gitDiceman/dspic33chSchematic/README.md

# dspic33chSchematic
hfc3100D dspic33ch128mp506 schematic
