gitDiceman/dspic33chSchematic/NEW_33CH128_SCHEMATIC/HFC3100D_Main Control_220928_Rev2_1_BOM_220928(수정221014).xlsx

자 재 명 세 서
품 명 : 축전지용 충전기 |  |  |  |  |  |  |  |  | 10/14수정
MODEL : HFC3100D |  |  |  |  | PART : Main Control B/D
NO : 22-04-25 Rev 2.0 -> Rev 2.1 |  |  |  |  |  |  |  |  | 2022.10.14
NO | 품명 | 심볼 | TYPE | 규격 | 단위 | 수량 | 단가 | 금액 | 비고
1 | CAP. | C21,C25,C26,C27,C28, C29,C30,C31,C34,C37, C40,C41,C42,C43,C44, C45,C46,C47,C48,C51, C52,C53,C54,C55,C62, C71,C72,C73,C74,C75, C76,C77,C78,C79,C80, C83,C84,C24 | SMD (2012) | C104/2012 | EA | 38 | 60 | 2280
2 |  | C61_X,C64_X,C69_X |  | C105/2012 | EA | 0
3 |  | BT1 |  | S-CAP-1F/5.5V/20pi/5pitch | EA | 0 |  |  | 미삽
4 |  | C1 | EL | 100uF/250V | EA | 1 | 60 | 60
5 |  | C2,C3 | MY | M104/2E | EA | 2 | 60 | 120
6 |  | C4 | CC | C331/1KV | EA | 1 | 60 | 60
7 |  | C5,C7,C8 | EL | 1000uF/25V | EA | 3 | 60 | 180
8 |  | C6 | EL | 47uF/25V | EA | 1 | 60 | 60
9 |  | C9,C14 | CC | C104 | EA | 2 | 60 | 120
10 |  | C10 | CC | 471C | EA | 1 | 60 | 60
11 |  | C11,C12,C16,C19 | EL | 220uF/50V | EA | 4 | 60 | 240
12 |  | C22,C32,C35,C49 | SMD(2012) | C222/50V(2012) | EA | 5 | 60 | 300
13 |  | C15 | EL | 100uF/50V | EA | 1 | 60 | 60
14 |  | C17,C20 | EL | 47uF/50V | EA | 2 | 60 | 120
15 |  | C18,C13 | MY | M222/2A | EA | 2 | 60 | 120
16 |  | C23,C33 | MY | M473/250V(630V) | EA | 2 | 60 | 120
17 |  | C36 | EL | 470u/25V | EA | 1 | 60 | 60
18 |  | C38,C39 | SMD(2012) | 30P/2012 | EA | 2 | 60 | 120
19 |  | C50 | MY | M474/16V | EA | 1 | 60 | 60
20 |  | C56_X,C57_X,C58_X |  | 47uF | EA | 0 |  |  | 미삽
21 |  | C60_X,C63_X,C68_X |  | 22uF | EA | 0 |  |  | 미삽
22 |  | C70 |  | 10uF/50V | EA | 0 | 60 | 0 | 미삽
23 |  | C81,C82 |  | 220uF/25V/8pi | EA | 2 | 60 | 120
24 | DIODE | D1,D3,D8,D11,D13,D14,D15,D23 |  | UF4007 | EA | 8 | 60 | 480
25 |  | D2,D4 |  | 1N5404 | EA | 2 | 60 | 120
26 |  | D5,D7,D12 |  | UF5401 | EA | 3 | 60 | 180
27 |  | D6 |  | 1N5406 | EA | 1 | 60 | 60
28 |  | D9 |  | 1N4747 | EA | 1 | 60 | 60
29 |  | D10 |  | 1N4749 | EA | 1 | 60 | 60
30 |  | D16,D17,D18,D19,D20,D21,D24,D25 | SMD | 1N4148/SOD80 | EA | 8 | 60 | 480
31 |  | D22 |  | 1N4733 | EA | 1 | 60 | 60
32 |  | D26_X,D27_X,D28_X,D29_X,D30_X, D31_X |  | 1N4007 | EA | 0 |  |  | 미삽
33 |  | D33,D34 |  | SMBJ13CA | EA | 2 | 60 | 120
34 | CONN. | J2 |  | 53258-8P | EA | 1 | 60 | 60
35 |  | J3 |  | 53258(2P) | EA | 0 | 60 | 0 | 미삽
36 |  | J1 |  | PCN10-64ACP-2.54DS | EA | 1 | 60 | 60
37 |  | J4 |  | HIF3BA-20PA-2.54DSA | EA | 0 | 60 | 0 | 미삽
38 |  | J5 |  | 5269-5P | EA | 1 | 60 | 60
39 |  | J6 |  | 5267-5P | EA | 1 | 60 | 60
40 | FET | Q1 |  | IRF830 | EA | 1 | 60 | 60
41 | TR | Q2 |  | 2N2222/SOT23 | EA | 0 | 60 | 0 | 미삽
42 | NTC | RT1,RT2 |  | 20D15 | EA | 2 | 60 | 120
43 | RES. | R18,R30,R43 | SMD (3216) | 3K/3216 | EA | 3 | 60 | 180
44 |  | R19,R22,R39,R42 |  | 100K/3216 | EA | 4 | 60 | 240 | R84_X,R89_X, R96_X-미삽
45 |  | R20,R40,R45,R64 |  | 270R/3216 | EA | 4 | 60 | 240
46 |  | R21,R41,R63 |  | 100R/3216 | EA | 3 | 60 | 180
47 |  | R23,R24,R25,R26,R27,R28,R29,R46, R47,R48,R49,R50,R51,R52,R74, |  | 10K/3216 | EA | 15 | 60 | 900 | R85_X,R90_X, R97_X-미삽
48 |  | R31,R32,R33,R34,R36,R37,R38,R55, R56,R57,R58,R59,R60,R61 |  | 1R/3216 | EA | 14 | 60 | 840
49 |  | R44 |  | 4K/3216 | EA | 1 | 60 | 60
50 |  | R53 |  | 3.8k/3216 | EA | 1 | 60 | 60
51 |  | R54 |  | 33k/3216 | EA | 1 | 60 | 60
52 |  | R62,R65,R66,R70,R71,R107,R108, R109,R110, R111,R112,R113 |  | 1K/3216 | EA | 12 | 60 | 720 | R77_X,R78_X, R79_X, -미삽
53 |  | R67,R68 |  | 1.5K/3216 | EA | 2 | 60 | 120
54 |  | R69,R72,R75,R76 |  | 0R/3216 | EA | 4 | 60 | 240
55 |  | R73 |  | 1.2K/3216 | EA | 1 | 60 | 60
56 |  | R80 |  | 4.7K/3216 | EA | 1 | 60 | 60
57 |  | R82,R88,R93,R94,R95,R114 |  | 560R/3216 | EA | 6 | 60 | 360
58 |  | R83,R99 |  | 120R/3216 | EA | 2 | 60 | 120
59 |  | R86_X,R91_X,R98_X |  | 27K/3216 | EA | 0 |  |  | 미삽
60 | RES. | R1,R10,R16 | LEAD | 500R | EA | 3 | 60 | 180
61 |  | R2,R3 |  | 10K/5W | EA | 2 | 60 | 120
62 |  | R4,R12 |  | 1K | EA | 2 | 60 | 120
63 |  | R5 |  | 20K/5W | EA | 1 | 60 | 60
64 |  | R6 |  | 12K | EA | 1 | 60 | 60
65 |  | R7 |  | 47K | EA | 1 | 60 | 60
66 |  | R8 |  | 33R | EA | 1 | 60 | 60
67 |  | R9 |  | 10K | EA | 1 | 60 | 60
68 |  | R11 |  | 2.2K | EA | 1 | 60 | 60
69 |  | R13 |  | 7.7K | EA | 1 | 60 | 60
70 |  | R14,R17 |  | 5K | EA | 2 | 60 | 120
71 |  | R15 |  | 0.5R-2W | EA | 1 | 60 | 60
72 |  | R35 |  | 3K | EA | 1 | 60 | 60
73 |  | R103_X,R104_X,R105_X |  | 1K/2W | EA | 0 |  |  | 미삽
74 | TRANS | T1 |  | TDK-PC44PQ32/30 ( HFC-3125DMC-T2) | EA | 1 | 60 | 60
 | TP | GND,VSS,VDD,VCC |  | TestPin | EA | 4 |  |  | 추가
 | Tact SW | RESET |  | TACT SW - 4mm | ea | 1 |  |  | 추가
75 |  | L1 |  | TNC-CH535140 | EA | 1 | 60 | 60
76 |  | TRANS2_X,TRANS3_X,TRANS4_X |  | HD41*20(10:1) | EA | 0 |  |  | 미삽
77 | IC | U1,U3,U4 |  | LM150/TO220 | EA | 3 | 60 | 180
78 |  | U2 |  | UC3845N/DIP | EA | 1 | 60 | 60
79 |  | U5 | SMD | LM358/SOIC | EA | 1 | 60 | 60
80 |  | U6,U9 | SMD | 74HC245/TSSOP | EA | 2 | 60 | 120
81 |  | U7 | SMD | dsPIC33CH128MP506T/I_PT | EA | 1 | 60 | 60
82 |  | U8 | SMD | LM2904/SOIC | EA | 1 | 60 | 60
83 |  | U10 | SMD | OP-07/SOIC | EA | 1 | 60 | 60
84 |  | U11 | SMD | NXP 74HC4050D (SOL16-P-150 3.9mm) | EA | 1 | 60 | 60
85 |  | U13 |  | LD1117-3.3V/TO220 | EA | 1 | 60 | 60
86 |  | U14 | SMD | MAX3485CSA/SO8 | EA | 1 | 60 | 60
87 |  | U15 | SMD | DS1302SN/SOIC | EA | 0 | 60 | 0 | 미삽
88 |  | U16 | SMD | MAX3051/SO | EA | 0 | 60 | 0 | 미삽
89 |  | U17 | SMD | AT24C64D/SOIC | EA | 1 | 60 | 60
90 |  | U18 | SMD | SP3232EBET/WSOIC-16 | EA | 1 | 60 | 60
91 | VR | VR1,VR2,VR3,VR4,VR5,VR6 |  | VR1K(102)/3296W | EA | 6 | 60 | 360
92 |  | VR7 |  | 20K(203)/3296W | EA | 1 | 60 | 60
93 |  | VR8_X,VR9_X,VR10_X |  | VR20K/3296W | EA | 0 | 60 | 0
94 |  | VR11_X,VR12_X,VR13_X |  | VR100K/3296W | EA | 0 | 60 | 0
95 |  | FUSE HOLDER |  | BR-FH1(20mm) | EA | 1 | 60 | 60
96 | FUSE | FUSE1 |  | FUSE:3A 250V | EA | 1 | 60 | 60
97 |  | FUSE2_X,FUSE3_X,FUSE4_X |  | 1A/250V | EA | 0
98 | BZ | BZ1 |  | ALP1205S | EA | 0 |  |  | 미삽
99 | XTAL | Y1 |  | XTAL-8MHz/ATS | EA | 1 | 60 | 60
100 |  | Y3 |  | XTAL-32.768KHz/CAN | EA | 0 | 60 | 0 | 미삽
101 | IC | U12 |  | MCP121-300 (TO-92) | EA | 1 | 60 | 60 | 추가
102 | H/S |  |  | SY-200*25mm | EA | 1 | 60 | 60
103 | H/S |  |  | SY-403*45mm | EA | 3 | 60 | 180
104 | H/S | U1 |  | SY-403*65mm | EA | 1 | 60 | 60
105 | PCB | PART : Main Control B/D |  | NO : HFC3100D Main Control B/D 22-09-28 Rev2.1 | EA | 1 | 60 | 0 | U12추가
