gitDiceman/dspic33chSchematic/NEW_33CH128_SCHEMATIC/HFC3100D_Main LCD Display_220425_Rev2_0_BOM_220704(수정221014).xlsx

자 재 명 세 서
품 명 : 축전지용 충전기 |  |  |  |  |  |  |  |  | 10/14수정
MODEL : HFC3100D |  |  |  |  | PART : Main LCD B/D
NO : 22-04-25 Rev 2.0 |  |  |  |  |  |  |  |  | 2022.10.14
NO | 품명 | 심볼 | TYPE | 규격 | 단위 | 수량 | 단가 | 금액 | 비고
1 | CAP. | C1,BC1,BC2,C4,C5,C6,C7,C8,C9,C10,C11,C12,C18,C19 | SMD | C104/2012/50V | EA | 14 | 20 | 280
2 |  | C2,C3 |  | 30P/2012/50V | EA | 2 | 20 | 40
3 |  | C13,C14,C15,C16 |  | 105/2012/50V | EA | 4 | 20 | 80
4 |  | BT1 | DIP | 1F/5.5V | EA | 1 | 20 | 20
5 |  | EC1 |  | 47uF/25V/5pi/DIP | EA | 1 | 20 | 20
6 |  | C17 |  | 10uF/50V/5pi/DIP | EA | 1 | 20 | 20
7 | LED | D1,D2,D3,D4,D5,D6,D7,D8,D9,D10,D12,D13,D14, D15,D16 |  | LED/3pi/GRN | EA | 15 | 20 | 300
8 |  | D11 |  | LED/3pi/RED | EA | 1 | 20 | 20
9 | 고무 | D1,D2,D3,D4,D5,D6,D7,D8,D9,D10,D12,D11, D13,D14,D15,D16 |  | 5mm | EA | 16 | 20 | 320
10 | CONN. | CN2 |  | 5267-5P | EA | 1 | 20 | 20
11 |  | J1 |  | 53258-5P | EA | 1 | 20 | 20
12 |  | J2 |  | 53258-2P | EA | 0 | 20 | 0 | 미삽
13 | RES. | R1 | SMD | 4.7K/3216/J | EA | 1 | 20 | 20
14 |  | R3,R7,R34 |  | 10K/3216/J | EA | 3 | 20 | 60
15 |  | R5,R10,R33,R35,R36,R37,R38,R39,R40,R42 |  | 1K/3216/J | EA | 10 | 20 | 200
16 |  | R6 |  | 470R/3216/J | EA | 1 | 20 | 20
17 |  | R8,R9,R14,R30,R31,R32 |  | 2K/3216/J | EA | 6 | 20 | 120
18 |  | R11,R13 |  | 560R/3216/J | EA | 2 | 20 | 40
19 |  | R12 |  | 120R/3216/J | EA | 1 | 20 | 20
20 |  | R15,R16,R17,R18,R19,R20,R21,R22,R23,R24,R25,R26,R27,R28,R29,R41 |  | 820R/3216/J | EA | 16 | 20 | 320
21 |  | R4 | LEAD | 10R/0.5W/LEAD | EA | 1 | 20 | 20
22 | TACT SW | RESET | DIP | TACT-4mm | EA | 1 | 20 | 20
23 |  | SW1,SW2,SW3,SW4,SW5,SW6,SW7 |  | TACT-12mm | EA | 7 | 20 | 140
24 | TP | TP1,TP2,TP3,TP4,TP5,TP6,TP7,TP8,TP9 |  | TP | EA | 0 | 20 | 0 | 미삽
 | TP | GND1 |  | TP | EA | 1 |  |  | 추가
25 | IC | U1 | TO-92 | MCP121-300 | EA | 1 | 20 | 20 | 부품변경
26 |  | Q1,Q2 | SOT-23 | MMBT2222A/SOT-23 | EA | 2 | 20 | 40
27 |  | U2 | TQFP | dsPIC33CH128MP506T-I_PT(64P) | EA | 1 | 20 | 20
28 |  | U3 | WSOIC | SP3232EBET/WSOIC-16 | EA | 1 | 20 | 20
29 |  | U4 | SO8 | MAX3485CAS/SO8 | EA | 1 | 20 | 20 | 미삽
30 |  | U5 | SOIC | DS1302Z+T&S(150)/SOIC | EA | 1 | 20 | 20
31 |  | U6 | SOIC | AT24C64D/SOIC | EA | 1 | 20 | 20
32 |  | U7 | SOP16 | NXP 74HC4050D (SOL16-P-150 3.9mm) | EA | 1 | 20 | 20
33 | BUZZER | BZ1 | DIP | ALP1205S | EA | 1 | 20 | 20
34 | CHAR.LCD | CN1 | 16X4 CH | HC16401 | EA | 1 | 20 | 20
35 | XTAL | Y1 | ATS | XTAL-8MHz | EA | 1 | 20 | 20
36 | XTAL | Y2 | CAN | XTAL-32.768KHz | EA | 1 | 20 | 20
37 | PCB | PART : Main LCD B/D |  | 22-04-25 Rev 2.0 | EA | 1 | 20 | 20
 |  |  |  | Main LCD 및 Module LCD의 LED 고무는 기존 규격하고 맞는지 확인 바랍니다.
