gitDiceman/dspic33chSchematic/NEW_33CH128_SCHEMATIC/HFC3100D_Module_Display_220425_Rev3_1_BOM_220704(수정221014).xlsx

 |  |  |  | 자 재 명 세 서
품 명 : 축전지용 충전기
MODEL : HFC3100D |  |  |  | PART : Module Display B/D |  |  |  |  | 10/14수정
NO : 22-04-25 Rev 3.0 |  |  |  |  |  |  |  |  | 2022.07.04
NO | 품명 | 규격 | 심볼 | 단위 | 수량 | 단가 | 금액 | TYPE | 비고
1 |  | C105/2012/50V | C1,C2,C3,C4,C14, C15,C16 | EA | 7 |  |  | SMD
2 |  | C104/2012/50V | C7,C17,C18,C19,C20, C21,C22,C23,C24,C25, C29,C30,C31,C32,C33, C34,C35,C37 | EA | 18 |  |  | SMD
3 |  | 30P/2012/50V | C27,C28 | EA | 2 |  |  | SMD | 0->2
4 |  | 22uF/10V/5pi/DIP | C36,C38 | EA | 2 |  |  | SMD
5 |  | 47uF/25V/5pi/DIP | C5,C8,C9,C10 | EA | 4 |  |  | DIP
6 |  | 10uF/50V/5pi/DIP | C6 | EA | 1
7 |  | 22uF/25V/5pi/DIP | C11,C12,C13 | EA | 3
8 |  | 1F/5.5V/DIP | BT1 | EA | 1
9 | DIODE | 1N4007/DIP | D1,D2,D3,D4,D5, D6 | EA | 6
10 | LED | LED/3pi/G | LD1,LD3,LD5,LD6,LD7, LD8 | EA | 6
11 |  | LED/3pi/R | LD2 | EA | 1
12 | 고무 | 5mm | LD1,LD2,LD3,LD5,LD6 | EA | 5
13 | CONN. | JUMPER(*) - 2.54PITCH | JP1 | EA | 0
14 |  | 5267-5P | CN1 | EA | 1
15 |  | 53258-4P | J1 | EA | 1
16 |  | 53258-5P | J4 | EA | 1 |  |  |  | J2미삽
17 |  | 53258-6P | J3 | EA | 0 |  |  |  | 미삽
18 |  | 53258-2P | J5,J6 | EA | 0 |  |  |  | 미삽
19 |  | 53258-7P | J7,J8 | EA | 2
 |  |  | J9,J10 | ea | 0 |  |  |  | 미삽(테스트용)
20 | RES. | 10K/3216/J | R1,R2,R3,R4,R8, R18,R31,R34,R37 | EA | 9 |  |  | SMD
21 |  | 470R/3216/J | R5,R9,R10,R11,R13, R14,R15,R16 | EA | 8 |  |  | SMD
22 |  | 1K/3216/J | R7,R17,R24,R25,R26, R27,R28,R29 | EA | 8 |  |  | SMD
23 |  | 4.7K/3216/J | R19,R42,R43,R44,R45 ,R46,R47 | EA | 7 |  |  | SMD
24 |  | 2K/3216/J | R21,R22,R23,R39 | EA | 4 |  |  | SMD
25 |  | 100K/3216/J | R30,R33,R36 | EA | 3 |  |  | SMD
26 |  | 27K/3216/J | R32,R35,R38 | EA | 3 |  |  | SMD
27 |  | 62R/3216/J | R40,R41 | EA | 2 |  |  | SMD
28 |  | 680R/1W/DIP | R6 | EA | 1 |  |  | DIP
29 | TACT | TACT-12mm | SW1,SW2,SW3,SW4 | EA | 4
30 |  | TACT-4mm | SW5 | EA | 1
31 | TP | TP | TP1,TP2,TP3,TP4 | EA | 0 |  |  |  | 미삽
 |  | TP | GND1 | ea | 1 |  |  |  | 추가
32 | IC | dsPIC33CH128MP506T/I_PT | U1 | EA | 1
33 |  | SP3232BET/WSOIC-16 | U2 | EA | 1
34 |  | MCP121-300 (TO-92) | U3 | EA | 1 |  |  |  | 부품교체
35 |  | MAX3051/SO | U4 | EA | 1
36 |  | DS1302SN/SOIC | U5 | EA | 1
37 |  | AT24C64D/SOIC | U6 | EA | 1
38 |  | 74HC245/TSSOP | U7,U8 | EA | 2
39 |  | LD1117IMP-3.3/SOT223 | U9 | EA | 1
40 |  | MMBT2222A/SOT-23 | Q1,Q2 | EA | 2
41 | TRANS | HD41*20 | T1,T2,T3 | EA | 3
42 | VR | 3296X/203(VR20K) | VR1,VR2,VR3 | EA | 3
43 |  | 3296X/104(VR100K) | VR4,VR5,VR6 | EA | 3
44 |  | 3362P/102(VR1K) | VR7 | EA | 1
45 | BUZZER | ALP1205S | BZ1 | EA | 1
46 | FUSE | 1A/250V/HOLDER | F1,F2,F3 | EA | 3
47 | G.LCD | WG12864A | LCD1 | EA | 1
48 | XTAL | XTAL-8MHz/ATS | Y1 | EA | 1 |  |  | ATS
49 |  | XTAL-32.768KHz/CAN | Y3 | EA | 1
50 | PCB | 22-09-28 Rev3.1 | HFC3100D Module LCD Display B/D | EA | 1 |  |  |  | 전압센싱보드포함
