gitDiceman/dspic33chSchematic/NEW_33CH128_SCHEMATIC/HFC3100D_Main Control_220425_Rev2_0_BOM.xlsx

 |  |  | 자 재 명 세 서
품 명 : 축전지용 충전기
MODEL : HFC3100D |  |  | PART : Main Control B/D
NO : 22-04-25 Rev 2.0 |  |  |  |  |  |  | 2022.04.25
NO | 품명 | 규격 | 단위 | 수량 | 심볼 | TYPE | 비고
1 | CAP. | C104/2012 | EA | 37 | C21,C25,C26,C27,C28, C29,C30,C31,C34,C37, C40,C41,C42,C43,C44, C45,C46,C47,C48,C51, C52,C53,C54,C55,C62, C71,C72,C73,C74,C75, C76,C77,C78,C79,C80, C83,C84 | SMD (2012)
2 |  | C105/2012 | EA | 0 | C61_X,C64_X,C69_X
3 |  | S-CAP-1F/5.5V/20pi/5pitch | EA | 1 | BT1
4 |  | 100uF/250V | EA | 1 | C1
5 |  | M104/2E | EA | 2 | C2,C3
6 |  | C331/1KV | EA | 1 | C4
7 |  | 1000uF/25V | EA | 3 | C5,C7,C8
8 |  | 47uF/25V | EA | 1 | C6
9 |  | C104 | EA | 3 | C9,C14,C24
10 |  | 471C | EA | 1 | C10
11 |  | 220uF/50V | EA | 4 | C11,C12,C16,C19
12 |  | M222/2A | EA | 5 | C13,C22,C32,C35,C49
13 |  | 100uF/50V | EA | 1 | C15
14 |  | 47uF/50V | EA | 2 | C17,C20
15 |  | M102/2A | EA | 1 | C18
16 |  | M473/250V | EA | 2 | C23,C33
17 |  | 470u/25V | EA | 1 | C36
18 |  | 30P/2012 | EA | 2 | C38,C39
19 |  | M474/50V | EA | 1 | C50
20 |  | 47uF | EA | 0 | C56_X,C57_X,C58_X
21 |  | 22uF | EA | 0 | C60_X,C63_X,C68_X
22 |  | 10uF/50V | EA | 1 | C70
23 |  | 220uF/25V/8pi | EA | 2 | C81,C82
24 | DIODE | UF4007 | EA | 8 | D1,D3,D8,D11,D13, D14,D15,D23
25 |  | 1N5404 | EA | 2 | D2,D4
26 |  | UF5401 | EA | 3 | D5,D7,D12
27 |  | 1N5406 | EA | 1 | D6
28 |  | 1N4747 | EA | 1 | D9
29 |  | 1N4749 | EA | 1 | D10
30 |  | 1N4148/SOD80 | EA | 8 | D16,D17,D18,D19,D20, D21,D24,D25
31 |  | 1N4733 | EA | 1 | D22
32 |  | 1N4007 | EA | 0 | D26_X,D27_X,D28_X,D29_X,D30_X, D31_X
33 |  | SMBJ13CA | EA | 2 | D33,D34
34 | CONN. | 53258-8P | EA | 1 | J2
35 |  | 53258(2P) | EA | 1 | J3
36 |  | PCN10-64ACP-2.54DS | EA | 1 | J3
37 |  | HIF3BA-20P | EA | 1 | J4
38 |  | 5269-5P | EA | 1 | J5
39 |  | 5267-5P | EA | 1 | J6
40 | FET | IRF830 | EA | 1 | Q1
41 | TR | 2N2222/SOT23 | EA | 1 | Q2
42 | NTC | 20D15 | EA | 2 | RT1,RT2
43 | RES. | 3K/3216 | EA | 3 | R18,R30,R43 | SMD (3216)
44 |  | 100K/3216 | EA | 4 | R19,R22,R39,R42,R84_X, R89_X,R96_X
45 |  | 270R/3216 | EA | 4 | R20,R40,R45,R64
46 |  | 100R/3216 | EA | 3 | R21,R41,R63
47 |  | 10K/3216 | EA | 15 | R23,R24,R25,R26,R27, R28,R29,R46,R47,R48, R49,R50,R51,R52,R74, R85_X,R90_X,R97_X
48 |  | 1R/3216 | EA | 14 | R31,R32,R33,R34,R36, R37,R38,R55,R56,R57, R58,R59,R60,R61
49 |  | 4K/3216 | EA | 1 | R44
50 |  | 3.8k/3216 | EA | 1 | R53
51 |  | 33k/3216 | EA | 1 | R54
52 |  | 1K/3216 | EA | 12 | R62,R65,R66,R70,R71, R77_X,R78_X,R79_X,R107,R108, R109,R110,R111,R112,R113
53 |  | 1.5K/3216 | EA | 2 | R67,R68
54 |  | 0R/3216 | EA | 4 | R69,R72,R75,R76
55 |  | 1.2K/3216 | EA | 1 | R73
56 |  | 4.7K/3216 | EA | 1 | R80
57 |  | 560R/3216 | EA | 6 | R82,R88,R93,R94,R95, R114
58 |  | 120R/3216 | EA | 2 | R83,R99
59 |  | 27K/3216 | EA | 0 | R86_X,R91_X,R98_X
60 | RES. | 500R | EA | 3 | R1,R10,R16 | LEAD
61 |  | 10K/5W | EA | 2 | R2,R3
62 |  | 1K | EA | 2 | R4,R12
63 |  | 20K/5W | EA | 1 | R5
64 |  | 12K | EA | 1 | R6
65 |  | 47K | EA | 1 | R7
66 |  | 33R | EA | 1 | R8
67 |  | 10K | EA | 1 | R9
68 |  | 2.2K | EA | 1 | R11
69 |  | 7.7K | EA | 1 | R13
70 |  | 5K | EA | 2 | R14,R17
71 |  | 0.5R-2W | EA | 1 | R15
72 |  | 3K | EA | 1 | R35
73 |  | 1K/2W | EA | 0 | R103_X,R104_X,R105_X
74 | TRANS | TDK-PC44PQ32/30 | EA | 1 | T1
75 |  | TNC-CH535140 | EA | 1 | L1
76 |  | HD41*20(10:1) | EA | 0 | TRANS2_X,TRANS3_X,TRANS4_X
77 | IC | LM150/TO220 | EA | 3 | U1,U3,U4
78 |  | UC3845N/DIP | EA | 1 | U2
79 |  | LM358/SOIC | EA | 1 | U5
80 |  | 74HC245/TSSOP | EA | 2 | U6,U9
81 |  | dsPIC33CH128MP506T/I_PT | EA | 1 | U7
82 |  | LM2904/SOIC | EA | 1 | U8
83 |  | OP-07/SOIC | EA | 1 | U10
84 |  | 74HC4050AF/SOP16 | EA | 1 | U11
85 |  | LD1117-3.3V/TO220 | EA | 1 | U13
86 |  | MAX3485CSA/SO8 | EA | 1 | U14
87 |  | DS1302SN/SOIC | EA | 1 | U15
88 |  | MAX3051/SO | EA | 1 | U16
89 |  | AT24C64D/SOIC | EA | 1 | U17
90 |  | SP3232EBET/WSOIC-16 | EA | 1 | U18
91 | VR | VR1K(102)/3296W | EA | 6 | VR1,VR2,VR3,VR4,VR5, VR6
92 |  | 20K(203)/3296W | EA | 1 | VR7
93 |  | VR20K/3296W | EA | 0 | VR8_X,VR9_X,VR10_X
94 |  | VR100K/3296W | EA | 0 | VR11_X,VR12_X,VR13_X
95 | FUSE | FUSE:3A 250V | EA | 1 | FUSE1
96 |  | 1A/250V | EA | 0 | FUSE2_X,FUSE3_X,FUSE4_X
97 | BZ | ALP1205S | EA | 1 | BZ1
98 | XTAL | XTAL-8MHz/ATS | EA | 1 | Y1
99 |  | XTAL-32.768KHz/CAN | EA | 1 | Y3
100 | IC | MCP121-300(TO92) | EA | 1 | U12 | TO92 | 22.07.28추가
