gitDiceman/dspic33chSchematic/NEW_33CH128_SCHEMATIC/HFC3100D_Main LCD Display_220425_Rev2_0_BOM.xlsx

 |  |  | 자 재 명 세 서
품 명 : 축전지용 충전기
MODEL : HFC3100D |  |  | PART : Main LCD B/D
NO : 22-04-25 Rev 2.0 |  |  |  |  |  |  | 2022.04.25
NO | 품명 | 규격 | 단위 | 수량 | 심볼 | TYPE | 비고
1 | CAP. | C104/2012/50V | EA | 14 | C1,BC1,BC2,C4,C5, C6,C7,C8,C9,C10, C11,C12,C18,C19 | SMD
2 |  | 30P/2012/50V | EA | 2 | C2,C3
3 |  | 105/2012/50V | EA | 4 | C13,C14,C15,C16
4 |  | 1F/5.5V | EA | 1 | BT1 | DIP
5 |  | 47uF/25V/5pi/DIP | EA | 1 | EC1
6 |  | 10uF/50V/5pi/DIP | EA | 1 | C17
7 | LED | LED/3pi/GRN | EA | 15 | D1,D2,D3,D4,D5, D6,D7,D8,D9,D10, D12,D13,D14,D15,D16
8 |  | LED/3pi/RED | EA | 1 | D11
9 | CONN. | 5267-5P | EA | 1 | CN2
10 |  | 53258-5P | EA | 1 | J1
11 |  | 53258-2P | EA | 1 | J2
12 | RES. | 4.7K/3216/J | EA | 1 | R1 | SMD
13 |  | 10K/3216/J | EA | 3 | R3,R7,R34
14 |  | 1K/3216/J | EA | 10 | R5,R10,R33,R35,R36, R37,R38,R39,R40,R42
15 |  | 470R/3216/J | EA | 1 | R6
16 |  | 2K/3216/J | EA | 6 | R8,R9,R14,R30,R31, R32
17 |  | 560R/3216/J | EA | 2 | R11,R13
18 |  | 120R/3216/J | EA | 1 | R12
19 |  | 820R/3216/J | EA | 16 | R15,R16,R17,R18,R19, R20,R21,R22,R23,R24, R25,R26,R27,R28,R29, R41
20 |  | 10R/0.5W/LEAD | EA | 1 | R4 | LEAD
21 | TACT SW | TACT-4mm | EA | 1 | RESET | DIP
22 |  | TACT-12mm | EA | 7 | SW1,SW2,SW3,SW4,SW5, SW6,SW7
23 | TP | TP | EA | 9 | TP1,TP2,TP3,TP4,TP5, TP6,TP7,TP8,TP9
24 | IC | HT7033A/TO-92 | EA | 0 | U1_X | TO-92
25 |  | MMBT2222A/SOT-23 | EA | 2 | Q1,Q2 | SOT-23
26 |  | dsPIC33CH128MP506T-I_PT(64P) | EA | 1 | U2 | TQFP
27 |  | SP3232EBET/WSOIC-16 | EA | 1 | U3 | WSOIC
28 |  | MAX3485CAS/SO8 | EA | 1 | U4 | SO8
29 |  | DS1302SN/SOIC | EA | 1 | U5 | SOIC
30 |  | AT24C64D/SOIC | EA | 1 | U6 | SOIC
31 |  | 74HC4050AF/SOP16 | EA | 1 | U7 | SOP16
32 | BUZZER | ALP1205S | EA | 1 | BZ1 | DIP
33 | CH.LCD | HC16401 | EA | 1 | CN1 | 16X4 CH
34 | XTAL | XTAL-8MHz | EA | 1 | Y1 | ATS
35 |  | XTAL-32.768KHz | EA | 1 | Y2 | CAN
