gitDiceman/dspic33chSchematic/NEW_33CH128_SCHEMATIC/HFC3100D_Module_Display_220425_Rev3_0_BOM.xlsx

 |  |  | 자 재 명 세 서
품 명 : 축전지용 충전기
MODEL : HFC3100D |  |  | PART : Module Display B/D
NO : 22-04-25 Rev 3.0 |  |  |  |  |  |  | 2022.04.25
NO | 품명 | 규격 | 단위 | 수량 | 심볼 | TYPE | 비고
1 |  | C105/2012/50V | EA | 7 | C1,C2,C3,C4,C14, C15,C16 | SMD
2 |  | C104/2012/50V | EA | 18 | C7,C17,C18,C19,C20, C21,C22,C23,C24,C25, C29,C30,C31,C32,C33, C34,C35,C37 | SMD
3 |  | 30P/2012/50V | EA | 0 | C27,C28 | SMD
4 |  | 22uF/10V/5pi/SMD | EA | 2 | C36,C38 | SMD
5 |  | 47uF/25V/5pi/DIP | EA | 4 | C5,C8,C9,C10 | DIP
6 |  | 10uF/50V/5pi/DIP | EA | 1 | C6
7 |  | 22uF/25V/5pi/DIP | EA | 3 | C11,C12,C13
8 |  | 1F/5.5V/DIP | EA | 1 | BT1
9 | DIODE | 1N4007/DIP | EA | 6 | D1,D2,D3,D4,D5, D6
10 | LED | LED/3pi/G | EA | 6 | LD1,LD3,LD5,LD6,LD7, LD8
11 |  | LED/3pi/R | EA | 1 | LD2
12 | CONN. | JUMPER(*) - 2.54PITCH | EA | 0 | JP1
13 |  | 5267-5P | EA | 1 | CN1
14 |  | 53258-4P | EA | 1 | J1
15 |  | 53258-5P | EA | 2 | J2,J4
16 |  | 53258-6P | EA | 1 | J3
17 |  | 53258-2P | EA | 2 | J5,J6
18 |  | 53258-7P | EA | 2 | J7,J8
19 | RES. | 10K/3216/J | EA | 9 | R1,R2,R3,R4,R8, R18,R31,R34,R37 | SMD
20 |  | 470R/3216/J | EA | 8 | R5,R9,R10,R11,R13, R14,R15,R16 | SMD
21 |  | 1K/3216/J | EA | 8 | R7,R17,R24,R25,R26, R27,R28,R29 | SMD
22 |  | 4.7K/3216/J | EA | 7 | R19,R42,R43,R44,R45 ,R46,R47 | SMD
23 |  | 2K/3216/J | EA | 4 | R21,R22,R23,R39 | SMD
24 |  | 100K/3216/J | EA | 3 | R30,R33,R36 | SMD
25 |  | 27K/3216/J | EA | 3 | R32,R35,R38 | SMD
26 |  | 62R/3216/J | EA | 2 | R40,R41 | SMD
27 |  | 680R/1W/DIP | EA | 1 | R6 | DIP
28 | TACT | TACT-12mm | EA | 4 | SW1,SW2,SW3,SW4
29 |  | TACT-4mm | EA | 1 | SW5
30 | TP | TP | EA | 4 | TP1,TP2,TP3,TP4
31 | IC | dsPIC33CH128MP506T/I_PT | EA | 1 | U1
32 |  | SP3232BET/WSOIC-16 | EA | 1 | U2
33 |  | HT7027A/TO-92(미삽) | EA | 0 | U3_X
34 |  | MAX3051/SO | EA | 1 | U4
35 |  | DS1302SN/SOIC | EA | 1 | U5
36 |  | AT24C64D/SOIC | EA | 1 | U6
37 |  | 74HC245/TSSOP | EA | 2 | U7,U8
38 |  | LD1117IMP-3.3/SOT223 | EA | 1 | U9
39 |  | MMBT2222A/SOT-23 | EA | 2 | Q1,Q2
40 | TRANS | HD41*20 | EA | 3 | T1,T2,T3
41 | VR | 3296X/203(VR20K) | EA | 3 | VR1,VR2,VR3
42 |  | 3296X/104(VR100K) | EA | 3 | VR4,VR5,VR6
43 |  | 3362P/102(VR1K) | EA | 1 | VR7
44 | BUZZER | ALP1205S | EA | 1 | BZ1
45 | FUSE | 1A/250V/HOLDER | EA | 3 | F1,F2,F3
46 | G.LCD | WG12864A | EA | 1 | LCD1
47 | XTAL | XTAL-8MHz | EA | 1 | Y1
48 |  | XTAL-32.768KHz | EA | 1 | Y3
