gitDiceman/dspic33chSchematic/NEW_33CH128_SCHEMATIC/temp/HFC3100D_MC_BOM.xlsx

HFC3100D_MC(MAIN CONTROL B/D)
 |  |  |  | 22.04.29
Item | 심볼 | Part | 수량 | 비고
1 | BT1 | S-CAP-1F/5.5V | 1
2 | BZ1 | ALP1205S | 1
3 | C1 | 100uF/250V | 1
4 | C2,3 | M104/2E | 2
5 | C4 | C331/1KV | 1
6 | C5,7,8 | 1000uF/25V | 3
7 | C6 | 47uF/25V | 1
8 | C9,14,21,24,25, C26,27,28,29,30, C31,34,37,40,41, C42,43,44,45,46, C47,48,51,52,53, C54,62,71,72,73, C74,75,76 | C104 | 33
9 | C10 | 471C | 1
10 | C11,12,16,19 | 220uF/50V | 4
11 | C13,22,32,35,49 | M222/2A | 5
12 | C15 | 100uF/50V | 1
13 | C17,20 | 47uF/50V | 2
14 | C38,39 | 30P | 2
15 | C18 | M102/2A | 1
16 | C21,22 | 220uF/25V/8pi | 2
17 | C23,C33 | M473/250V | 2
18 | C23, 44, 77, 78,79 | 104/2012/50V | 5
19 | C36 | 470u/25V | 1
20 | C50 | M474 | 1
21 | C55 | 104/2012 | 1
22 | C56, 57, 58 | 47uF | 3
23 | C60, 63, 68 | 22uF | 3
24 | C61, 64, 69 | C105 | 3
25 | C70 | 10uF/50V | 1
26 | D1, 3, 8, 11, 13, D14,15, 23 | UF4007 | 8
27 | D2, 4 | 1N5404 | 2
28 | D5, 7, 12 | UF5401 | 3
29 | D6 | 1N5406 | 1
30 | D9 | 1N4747 | 1
31 | D10 | 1N4749 | 1
32 | D16,17,18,19,20, D21,24,25 | 1N4148 | 8
33 | D22 | 1N4733 | 1
34 | D26, 27, 28, 29,30 D31 | 1N4007 | 6
35 | D33, 34 | SMBJ13CA | 2
36 | FUSE1 | FUSE:3A 250V | 1
37 | FUSE2, 3, 4 | 1A/250V | 3
38 | J1 | 53258-2P | 1
39 | J2 | 53258-8P | 1
40 | J3 | PCN10-64ACP-2.54DS | 1
41 | J4 | HIF3BA-20P | 1
42 | J5 | 5269-5P | 1
43 | J6 | 5267-5P | 1
44 | L1 | TRNSFMR 67127370 | 1
45 | Q1 | IRF830 | 1
46 | Q2 | 2N2222 | 1
47 | RT1, 2 | 20D15 | 2
48 |  | 20D15
49 | R1, 10, 16 | 500R | 3
50 |  | 500R
51 |  | 500R
52 | R2, 3 | 10K/5W | 2
53 |  | 10K/5W
54 | R4,12,62,65,66, R70,71,77,78,79, R107,108,109,110,111, R112,113 | 1K | 17
55 | R5 | 20K/5W | 1
56 | R6 | 12K | 1
57 | R7 | 47K | 1
58 | R8 | 33R | 1
59 | R9,23,24,25,26, R27,28,29,46,47, R48,49,50,51,52, R74,85,90,97 | 10K | 19
60 | R11 | 2.2K | 1
61 | R13 | 7.7K | 1
62 | R14,17 | 5K | 2
63 | R15 | 0.5R-2W | 1
64 | R18,30,35,43 | 3K | 4
65 | R19,22,39,42,84, 89,96 | 100k | 7
66 | R20,40,45,64 | 270R | 4
67 | R21,41,63 | 100R | 3
68 | R31, 32, 33,34,36, R37,38,55,56,57, R58,59,60,61 | 1R | 14
69 | R44 | 4K | 1
70 | R53 | 3.8k | 1
71 | R54 | 33k | 1
72 | R67,68 | 1.5K | 2
73 | R69,72,75,76 | 0R | 4
74 | R73 | 1.2K | 1
75 | R80 | 4.7K | 1
76 | R82,88,93,94,95, R114 | 560R | 6
77 | R83,99 | 120R | 2
78 | R86,91,98 | 27K | 3
79 | R103,104,105 | 1K/2W | 3
80 | TRANS2, 3, 4 | HD41*20(10:1) | 3
81 | T1 | TDK-PC44PQ32/30 | 1
82 | U1, 3, 4 | LM150/TO220 | 3
83 | U2 | UC3845N/DIP | 1
84 | U5 | LD1117-3.3V/TO220 | 1
85 | U5 | LM358(SOIC) | 1
86 | U6, 9 | 74HC245/TSSOP | 2
87 | U7 | dsPIC33CH128MP506T-I_PT(64P) | 1
88 | U8 | LM2904(SOIC) | 1
89 | U10 | OP-07(SOIC) | 1
90 | U11 | 74HC4050AF SOP16 | 1
91 | U14 | MAX3485CSA SO8 | 1
92 | U15 | DS1302SN SOIC | 1
93 | U16 | MAX3051 SO | 1
94 | U17 | AT24C64D SOIC | 1
95 | U18 | SP3232EBET/WSOIC-16 | 1
96 | VR1,2,3,4,5 VR6 | VR1K(102) | 6
97 | VR7 | 20K(203) | 1
98 | VR8,9,10 | VR20K | 3
99 | VR11,12,13 | VR100K | 3
100 | Y1 | XTAL-8MHz | 1
101 | Y3 | XTAL-32.768KHz | 1
