gitDiceman/dspic33chSchematic/NEW_33CH128_SCHEMATIC/temp/HFC3100D_MC_BOM_dspic33.xlsx

MC(POWER) 1/2 Revised: Tuesday, June 07, 2022
Revision: V1.0
Bill Of Materials June 7,2022 10:01:27 | Page1
Item | Quantity | Reference | Part
______________________________________________
1 | 1 | BT1 | S-CAP-1F/5.5V/20pi/5pitch
2 | 1 | BZ1 | ALP1205S
3 | 1 | C1 | 100uF/250V
4 | 2 | C2,C3 | M104/2E
5 | 1 | C4 | C331/1KV
6 | 3 | C5,C7,C8 | 1000uF/25V
7 | 1 | C6 | 47uF/25V
8 | 3 | C9,C14,C24 | C104
9 | 1 | C10 | 471C
10 | 4 | C11,C12,C16,C19 | 220uF/50V
11 | 5 | C13,C22,C32,C35,C49 | M222/2A
12 | 1 | C15 | 100uF/50V
13 | 2 | C17,C20 | 47uF/50V
14 | 1 | C18 | M102/2A
15 | 31 | C21,C25,C26,C27,C28, C29,C30,C31,C34,C37, C40,C41,C42,C43,C44, C45,C46,C47,C48,C51, C52,C53,C54,C62,C71, C72,C73,C74,C75,C76, C84 | C104/2012
16 | 2 | C23,C33 | M473/250V
17 | 1 | C36 | 470u/25V
18 | 2 | C38,C39 | 30P/2012
19 | 1 | C50 | M474
20 | 1 | C55 | 104/2012
21 | 3 | C56,C57,C58 | 47uF
22 | 3 | C60_O,C63_O,C68_O | 22uF
23 | 3 | C61_O,C64_O,C69_O | C105/2012
24 | 1 | C70 | 10uF/50V
25 | 5 | C77,C78,C79,C80,C83 | 104/2012/50V
26 | 2 | C81,C82 | 220uF/25V/8pi
27 | 8 | D1,D3,D8,D11,D13, D14,D15,D23 | UF4007
28 | 2 | D2,D4 | 1N5404
29 | 3 | D5,D7,D12 | UF5401
30 | 1 | D6 | 1N5406
31 | 1 | D9 | 1N4747
32 | 1 | D10 | 1N4749
33 | 8 | D16,D17,D18,D19,D20, D21,D24,D25 | 1N4148/SOD80
34 | 1 | D22 | 1N4733
35 | 3 | D26,D27,D28 | 1N4007
36 | 3 | D29_O,D30_O,D31_O | 1N4007/LEAD
37 | 2 | D33,D34 | SMBJ13CA
38 | 1 | FUSE1 | FUSE:3A 250V
39 | 3 | FUSE2_O,FUSE3_O,FUSE4_O | 1A/250V
40 | 1 | J2 | 53258-8P
41 | 1 | J3 | PCN10-64ACP-2.54DS
42 | 1 | J3 | 53258(2P)
43 | 1 | J4 | HIF3BA-20P
44 | 1 | J5 | 5269-5P
45 | 1 | J6 | 5267-5P
46 | 1 | L1 | TRNSFMR 67127370
47 | 1 | Q1 | IRF830
48 | 1 | Q2 | 2N2222/SOT23
49 | 2 | RT1,RT2 | 20D15
50 | 3 | R1,R10,R16 | 500R
51 | 2 | R2,R3 | 10K/5W
52 | 2 | R4,R12 | 1K
53 | 1 | R5 | 20K/5W
54 | 1 | R6 | 12K
55 | 1 | R7 | 47K
56 | 1 | R8 | 33R
57 | 1 | R9 | 10K
58 | 1 | R11 | 2.2K
59 | 1 | R13 | 7.7K
60 | 2 | R14,R17 | 5K
61 | 1 | R15 | 0.5R-2W
62 | 3 | R18,R30,R43 | 3K/3216
63 | 7 | R19,R22,R39,R42,R84_O,R89_O,R96_O | 100K/3216
64 | 4 | R20,R40,R45,R64 | 270R/3216
65 | 3 | R21,R41,R63 | 100R/3216
66 | 18 | R23,R24,R25,R26,R27, R28,R29,R46,R47,R48, R49,R50,R51,R52,R74, R85_O,R90_O,R97_O | 10K/3216
67 | 14 | R31,R32,R33,R34,R36, R37,R38,R55,R56,R57, R58,R59,R60,R61 | 1R/3216
68 | 1 | R35 | 3K
69 | 1 | R44 | 4K/3216
70 | 1 | R53 | 3.8k/3216
71 | 1 | R54 | 33k/3216
72 | 15 | R62,R65,R66,R70,R71, R77,R78,R79,R107,R108, R109,R110,R111,R112,R113 | 1K/3216
73 | 2 | R67,R68 | 1.5K/3216
74 | 4 | R69,R72,R75,R76 | 0R/3216
75 | 1 | R73 | 1.2K/3216
76 | 1 | R80 | 4.7K/3216
77 | 6 | R82,R88,R93,R94,R95, R114 | 560R/3216
78 | 2 | R83,R99 | 120R/3216
79 | 3 | R86_O,R91_O,R98_O | 27K/3216
80 | 3 | R103,R104,R105 | 1K/2W
81 | 1 | TRANS1 | TDK-PC44PQ32/30
82 | 3 | TRANS2_O,TRANS3_O,TRANS4_O | HD41*20(10:1)
83 | 1 | T1 | PC44PQ32/30
84 | 3 | U1,U3,U4 | LM150/TO220
85 | 1 | U2 | UC3845N
86 | 1 | U5 | LM358(SOIC)
87 | 2 | U6,U9 | 74HC245/TSSOP
88 | 1 | U7 | dsPIC33CH128MP506T-I_PT(64P)
89 | 1 | U8 | LM2904(SOIC)
90 | 1 | U10 | OP-07(SOIC)
91 | 1 | U11 | 74HC4050AF/SOP16
92 | 1 | U13 | LD1117-3.3V/TO220
93 | 1 | U14 | MAX3485CSA/SO8
94 | 1 | U15 | DS1302SN/SOIC
95 | 1 | U16 | MAX3051 SO
96 | 1 | U17 | AT24C64D/SOIC
97 | 1 | U18 | SP3232EBET/WSOIC-16
98 | 6 | VR1,VR2,VR3,VR4,VR5, VR6 | VR1K(102)
99 | 1 | VR7 | 20K(203)
100 | 3 | VR8,VR9,VR10 | VR20K
101 | 3 | VR11_O,VR12_O,VR13_O | VR100K
102 | 1 | Y1 | XTAL-8MHz/ATS
103 | 1 | Y3 | XTAL-32.768KHz/CAN
