gitDiceman/dspic33chSchematic/NEW_33CH128_SCHEMATIC/temp/HFC3100D_RD_BOM.xlsx

HFC3100D_RD(RECTIFIER DISPLAY B/D)
 |  |  |  | 22.04.29
Item | 심볼 | 규격 | 수량 | 비고
0 | PCB | HFC3100D_Module_Display_220425_Rev3_0 | 1
1 | BT1 | 1F/5.5V/DIP | 1
2 | BZ1 | ALP1205S | 1
3 | CN1 | 5267-5P | 1
4 | C1,C2,C3,C4,C14, C15,C16 | 105/2012/50V | 7
5 | C5,C8,C9,C10 | 47uF/25V/5pi/DIP | 4
6 | C6 | 10uF/50V/5pi/DIP | 1
7 | C7,C17,C18,C19,C20, C21,C22,C23,C24,C25, C29,C30,C31,C35,C37 | 104/2012/50V | 15
8 | C11,C12,C13 | 22uF/25V/5pi/DIP | 3
9 | C27,C28 | 30P/2012/50V | 2
11 | C32,C33,C34 | C104/2012 | 3
12 | C36,C38 | 22uF/10V/5pi/SMD | 2
13 | D1,D2,D3,D4,D5, D6 | 1N4007/LEAD | 6
14 | F1,F2,F3 | 1A/250V/FUSE HOLDER | 3
15 | JP1 | JUMPER(*) | 0
16 | J1 | 53258-4P | 1
17 | J2,J4 | 53258-5P | 2
18 | J3 | 53258-6P | 1
19 | J5,J6 | 53258-2P | 2
20 | J7,J8 | 53258-7P | 2
21 | LCD1 | WG12864A | 1
22 | LD1,LD3,LD5,LD6,LD7, LD8,LD9 | LED/3pi/G | 7
23 | LD2 | LED/3pi/R | 1
24 | Q1,Q2 | MMBT2222A/SOT-23 | 2
25 | R1,R2,R3,R4,R8, R18,R31,R34,R37 | 10K/3216/J | 9
26 | R5,R9,R10,R11,R13, R14,R15,R16,R48 | 470R/3216/J | 9
27 | R6 | 680R/1W/LEAD | 1
28 | R7,R17,R24,R25,R26, R27,R28,R29 | 1K/3216/J | 8
29 | R19 | 4.7K/3216/J | 1
30 | R20 | N.C | 0
31 | R21,R22,R23,R39 | 2K/3216/J | 4
32 | R30,R33,R36 | 100K/3216/J | 3
33 | R32,R35,R38 | 27K/3216/J | 3
34 | R40,R41 | 62R/3216/J | 2
35 | R42,R43,R44,R45,R46, R47 | 1K | 6
36 | SW1,SW2,SW3,SW4 | TACT-12mm | 4
37 | SW5 | TACT-4mm | 1
38 | TP1,TP2,TP3,TP4,TP5 | TP | 5
39 | T1,T2,T3 | HD41*20 | 3
40 | U1 | dsPIC33CH128MP506T-I_PT(64P) | 1
41 | U2 | SP3232BET/WSOIC-16 | 1
42 | U3 | HT7027A/TO-92(미삽) | 0
43 | U4 | MAX3051 SO | 1
44 | U5 | DS1302SN SOIC | 1
45 | U6 | AT24C64D SOIC | 1
46 | U7,U8 | 74HC245/TSSOP | 2
47 | U9 | LD1117IMP-3.3/SOT223 | 1
48 | VR1,VR2,VR3 | 3296X-203(VR20K) | 3
49 | VR4,VR5,VR6 | 3296X-104(VR100K) | 3
50 | VR7 | 3362/102/VR1K | 1
51 | Y1 | XTAL-8MHz(ATS) | 1
52 | Y3 | XTAL-32.768KHz | 1
