gitDiceman/dspic33chSchematic/hfc3100D_main_Lcd_display_rev3/HFC3100D_Main LCD Display_220530_Rev3_0_TOP.dxf

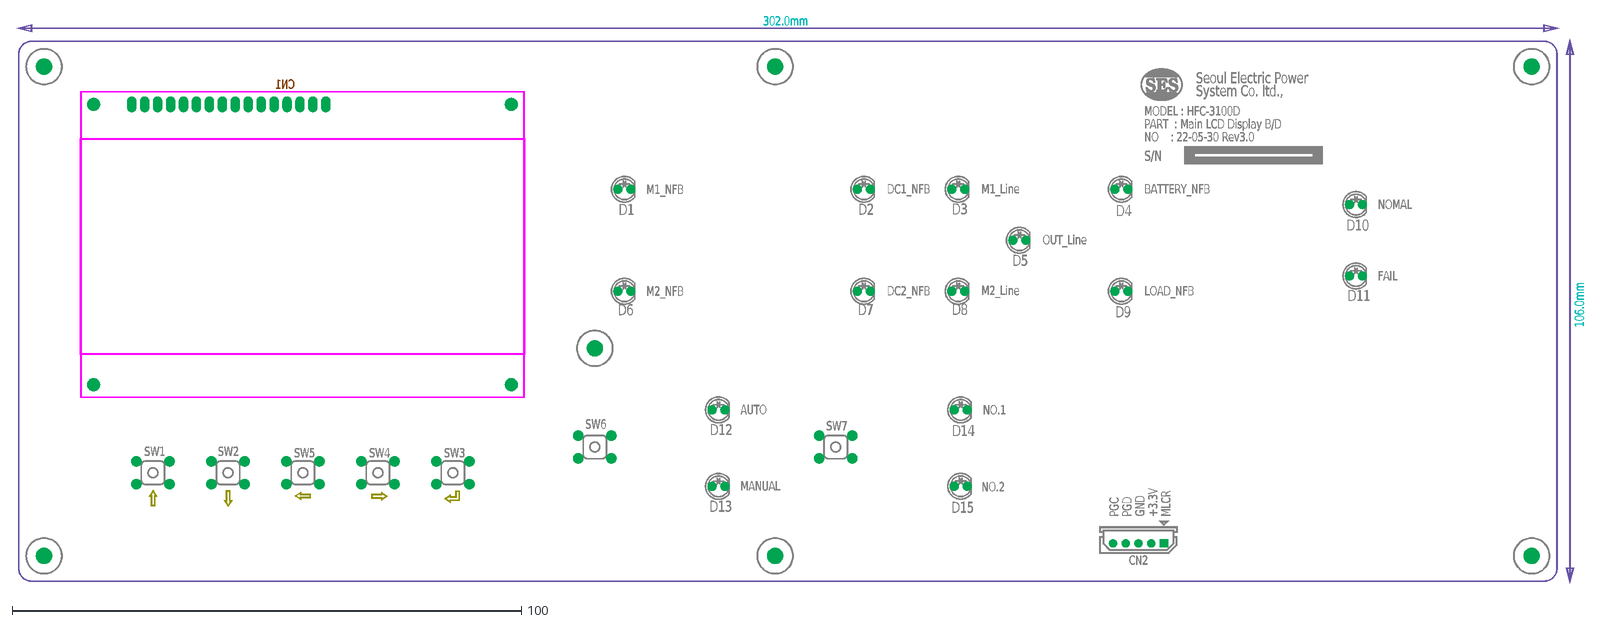
[picture p1: CAD file, 2022-09-23]
hfc3100D_main_Lcd_display_rev3/HFC3100D_Main LCD Display_220530_Rev3_0_TOP.dxf
302.0mm
106.0mm
PART : Main LCD Display B/D
MODEL : HFC-3100D
Seoul Electric Power
System Co. ltd.,
S/N
NO.1
M1_NFB
NOMAL
FAIL
NO : 22-05-30 Rev3.0
NO.2
M2_NFB
DC1_NFB
DC2_NFB
M1_Line
M2_Line
OUT_Line
PGC
PGD
GND
+3.3V
MLCR
AUTO
MANUAL
LOAD_NFB
BATTERY_NFB
SW6
SW1
SW2
SW3
SW4
SW5
SW7
D1
D6
D7
D2
D3
D8
D5
D15
D14
D10
D11
D9
D4
CN2
D12
D13
CN1
