gitDiceman/dspic33chSchematic/NEW_33CH128_SCHEMATIC/HFC3100D_Module_Display_Rev3.1.pdf

5 | 4 | 3 | 2 | 1

D

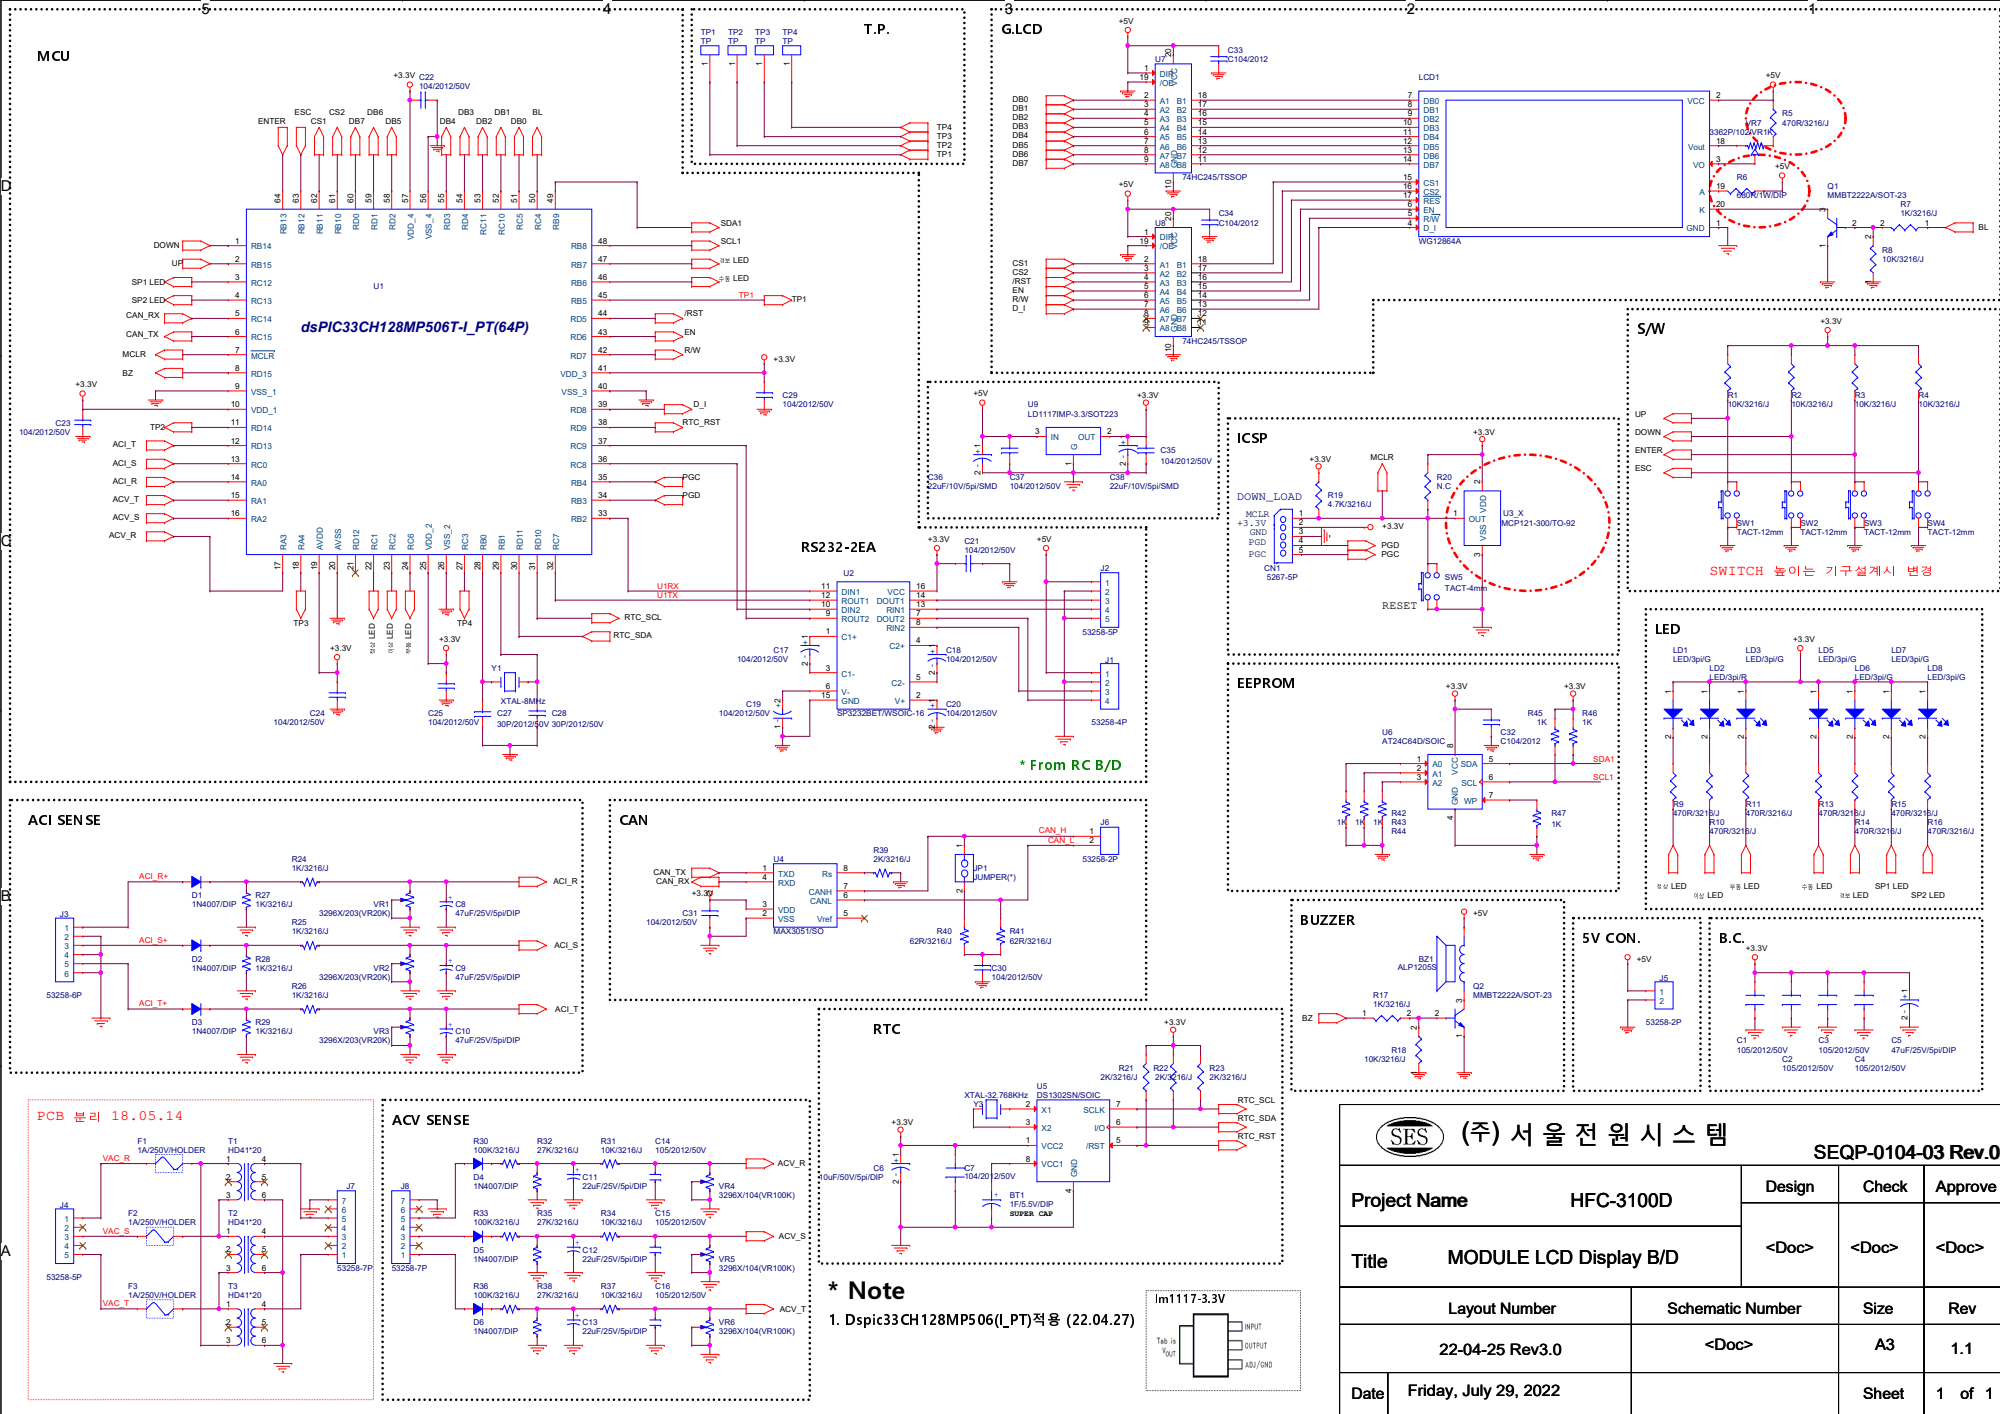
[picture p2: page 1]

SWITCH 높이는 기구설계시 변경
