gitDiceman/dspic33chSchematic/NEW_33CH128_SCHEMATIC/temp/MC_Power(DSPIC33CH128MP508).pdf

## 3.3V 방열판

# SY268 VCC

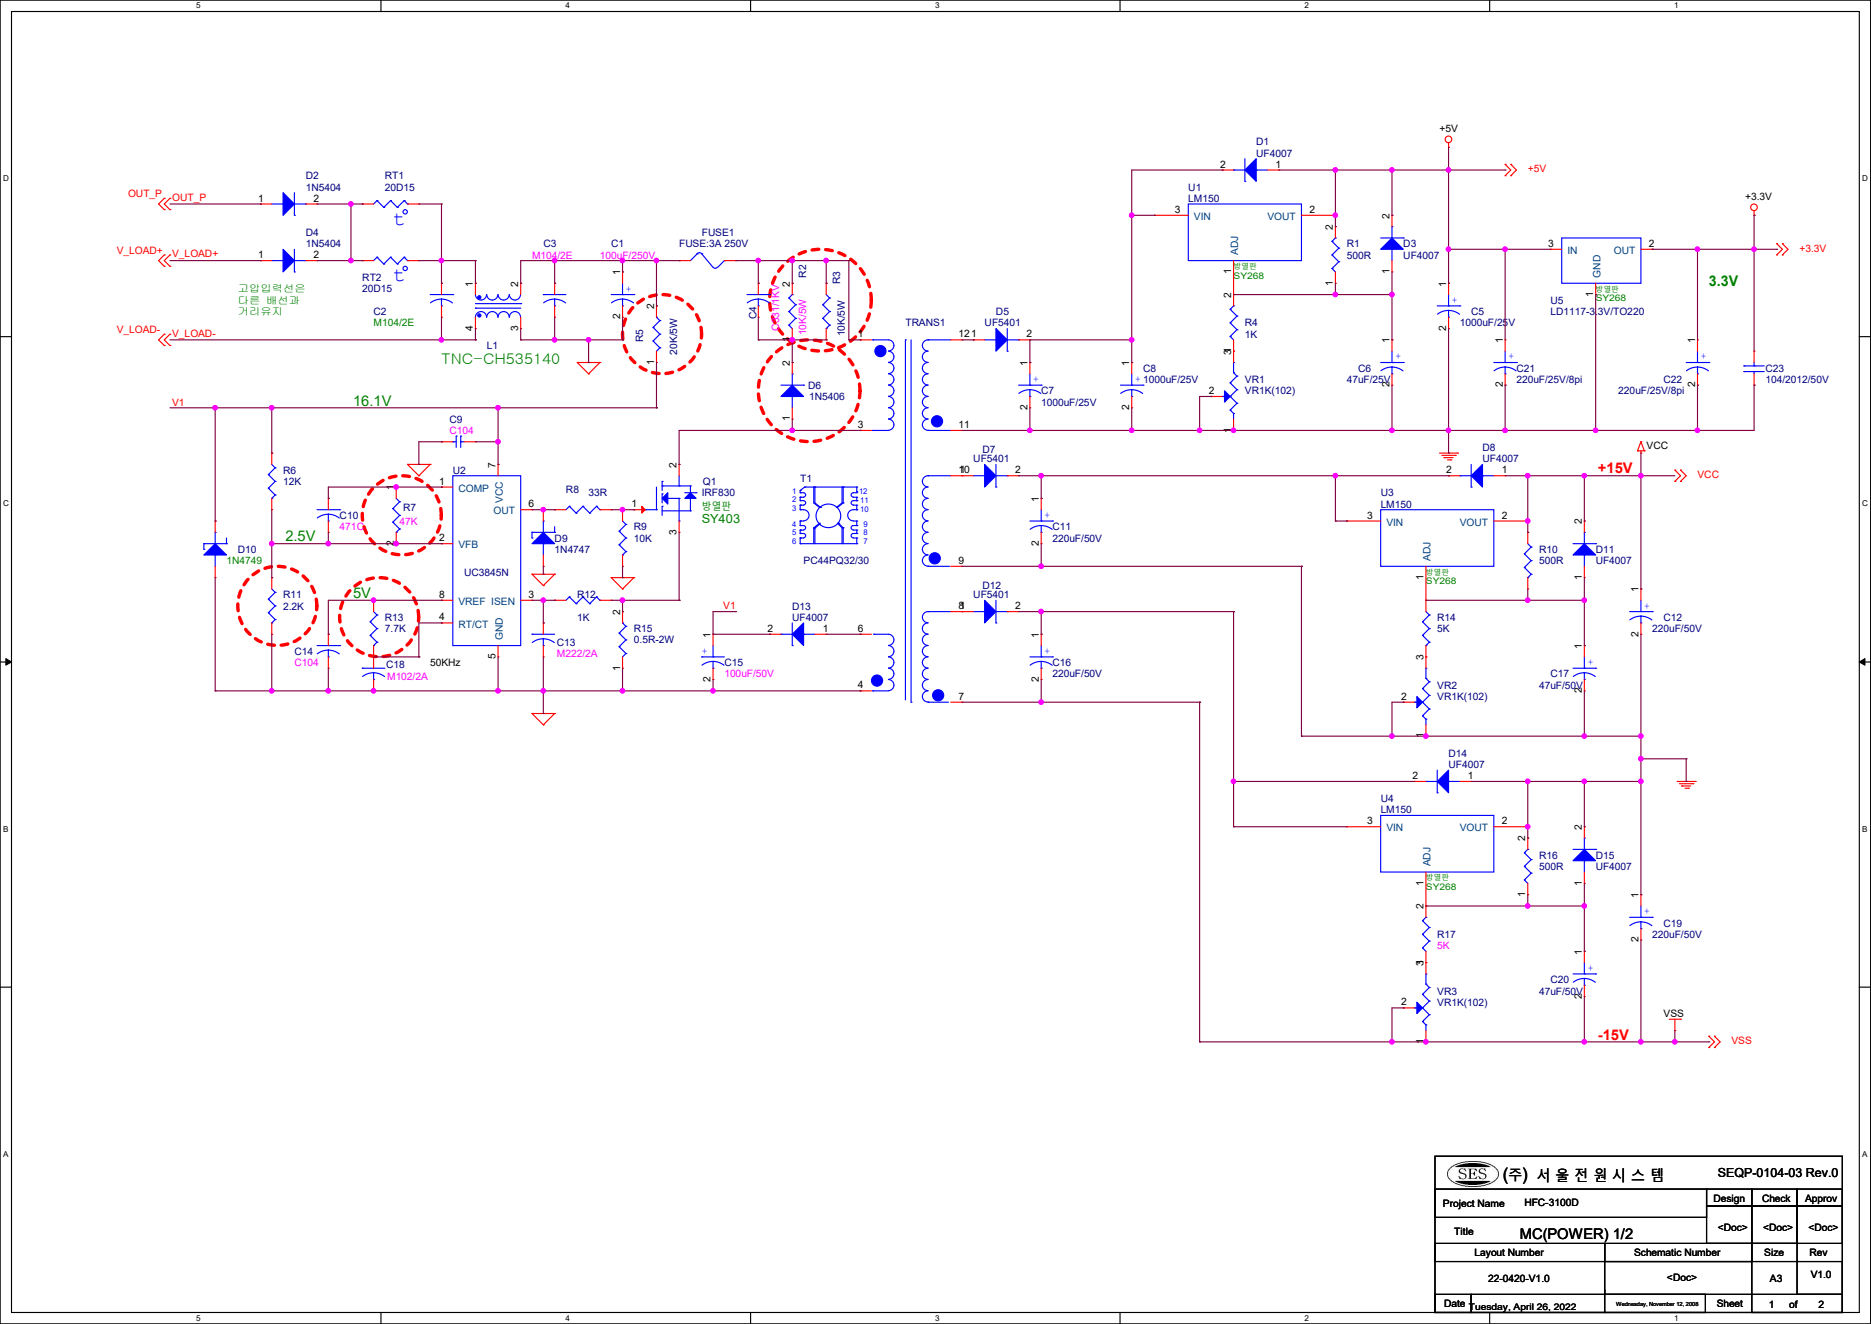
[picture p3: page 1]
