gitDiceman/dspic33chSchematic/NEW_33CH128_SCHEMATIC/temp/RD(DSPIC33CH128MP508).pdf

5 | 4 | 3 | 2 | 1

D

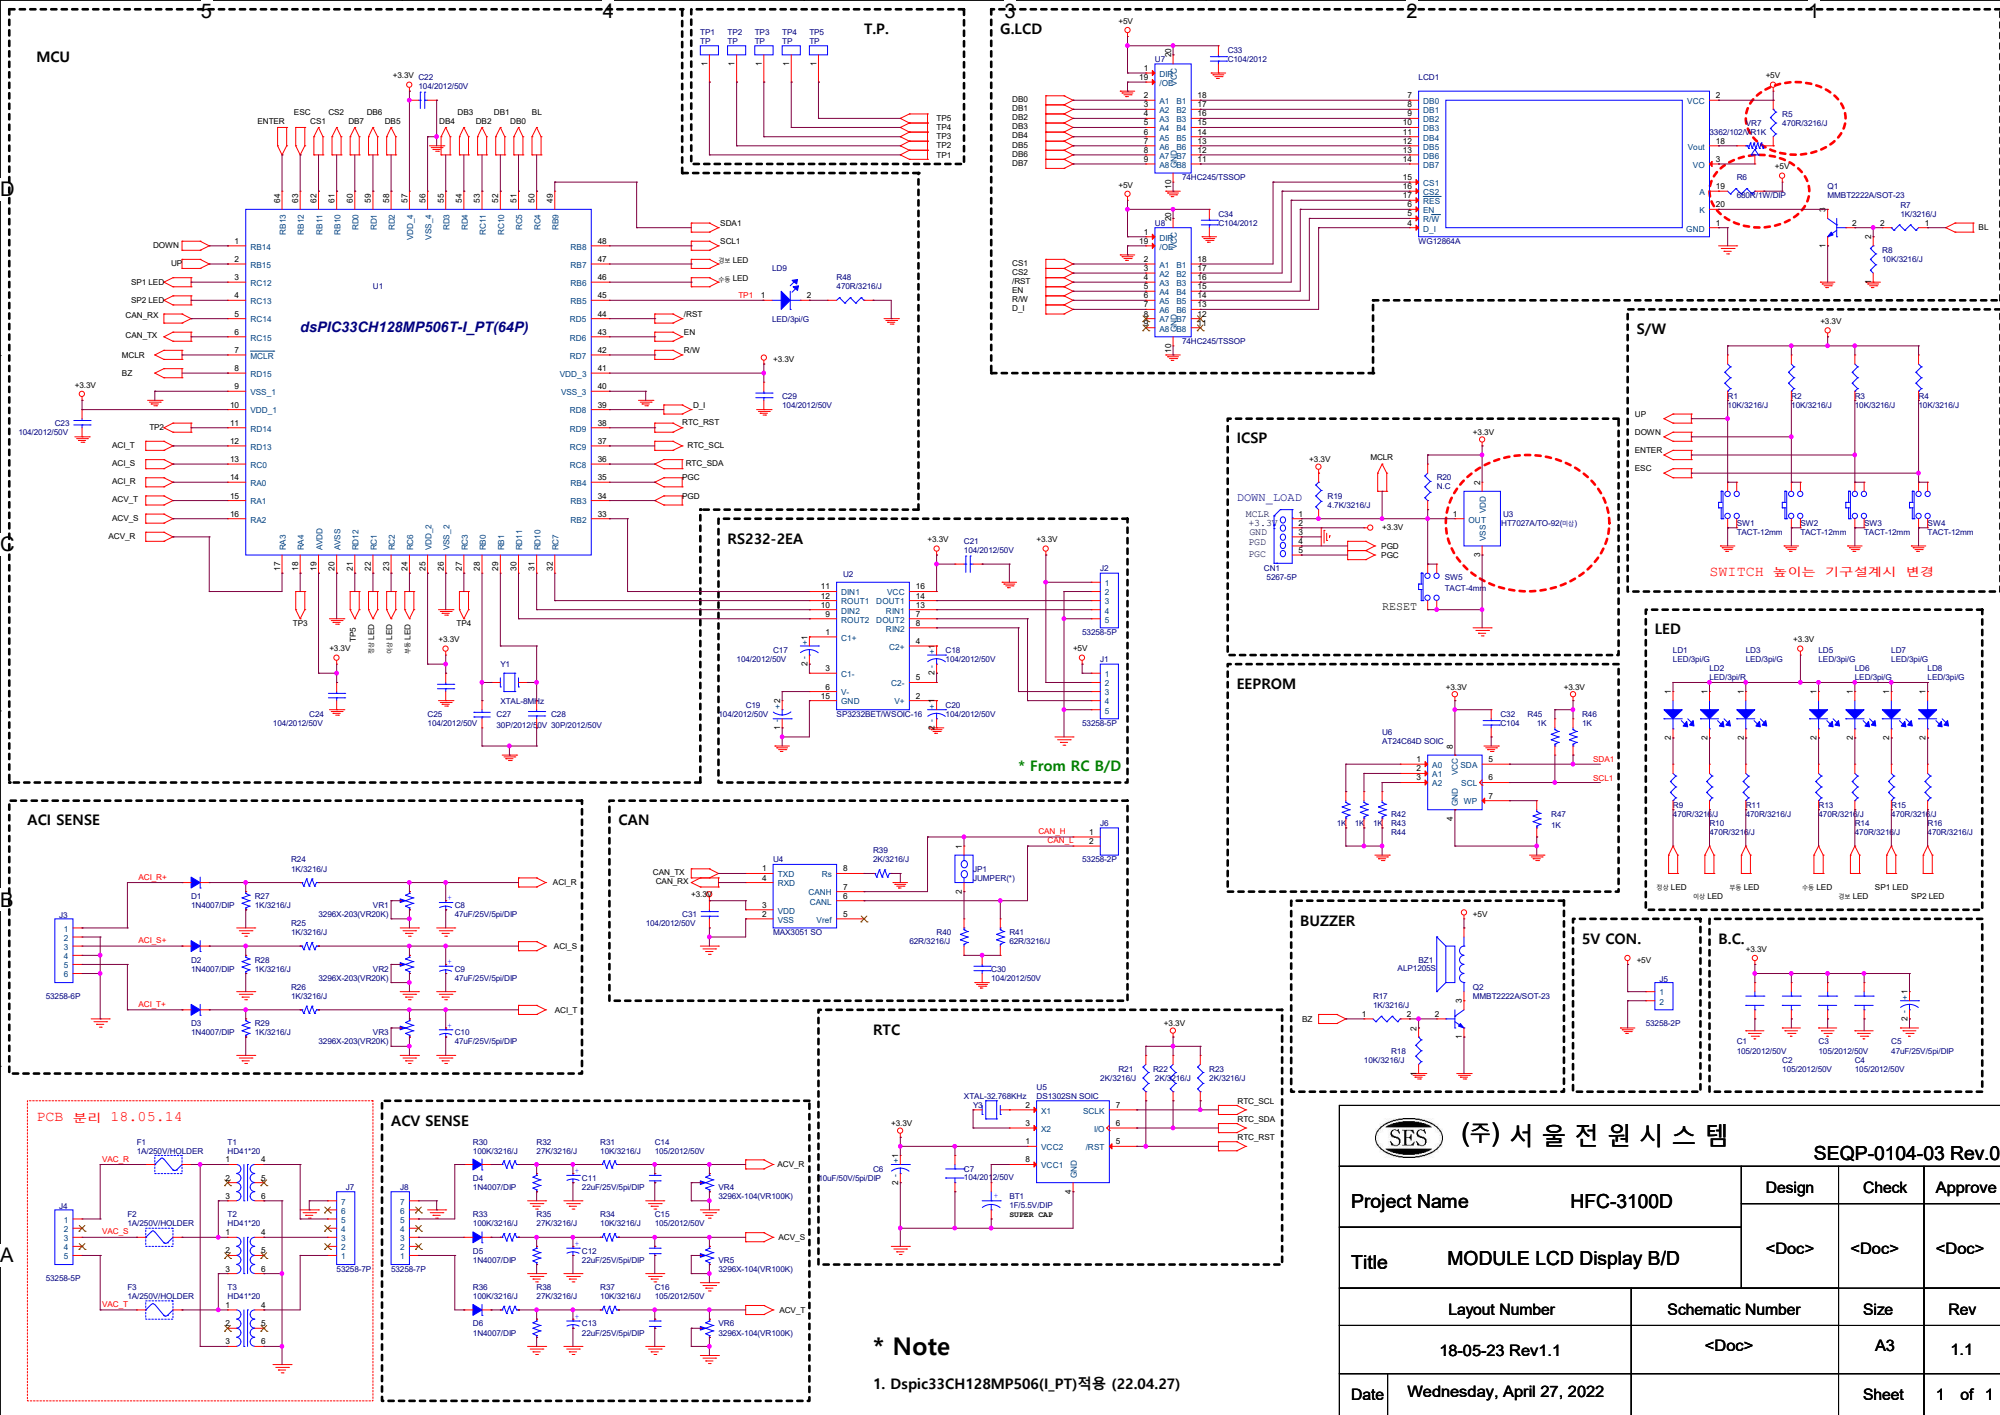
[picture p4: page 1]

74HC245/TSSOP VCC ²⁰ GND 10

SWITCH 높이는 기구설계시 변경
