gitDiceman/dspic33chSchematic/hfc3100d_mcuDspic33ch_RD_pcb.pdf

5 | 4 | 3 | 2 | 1

D

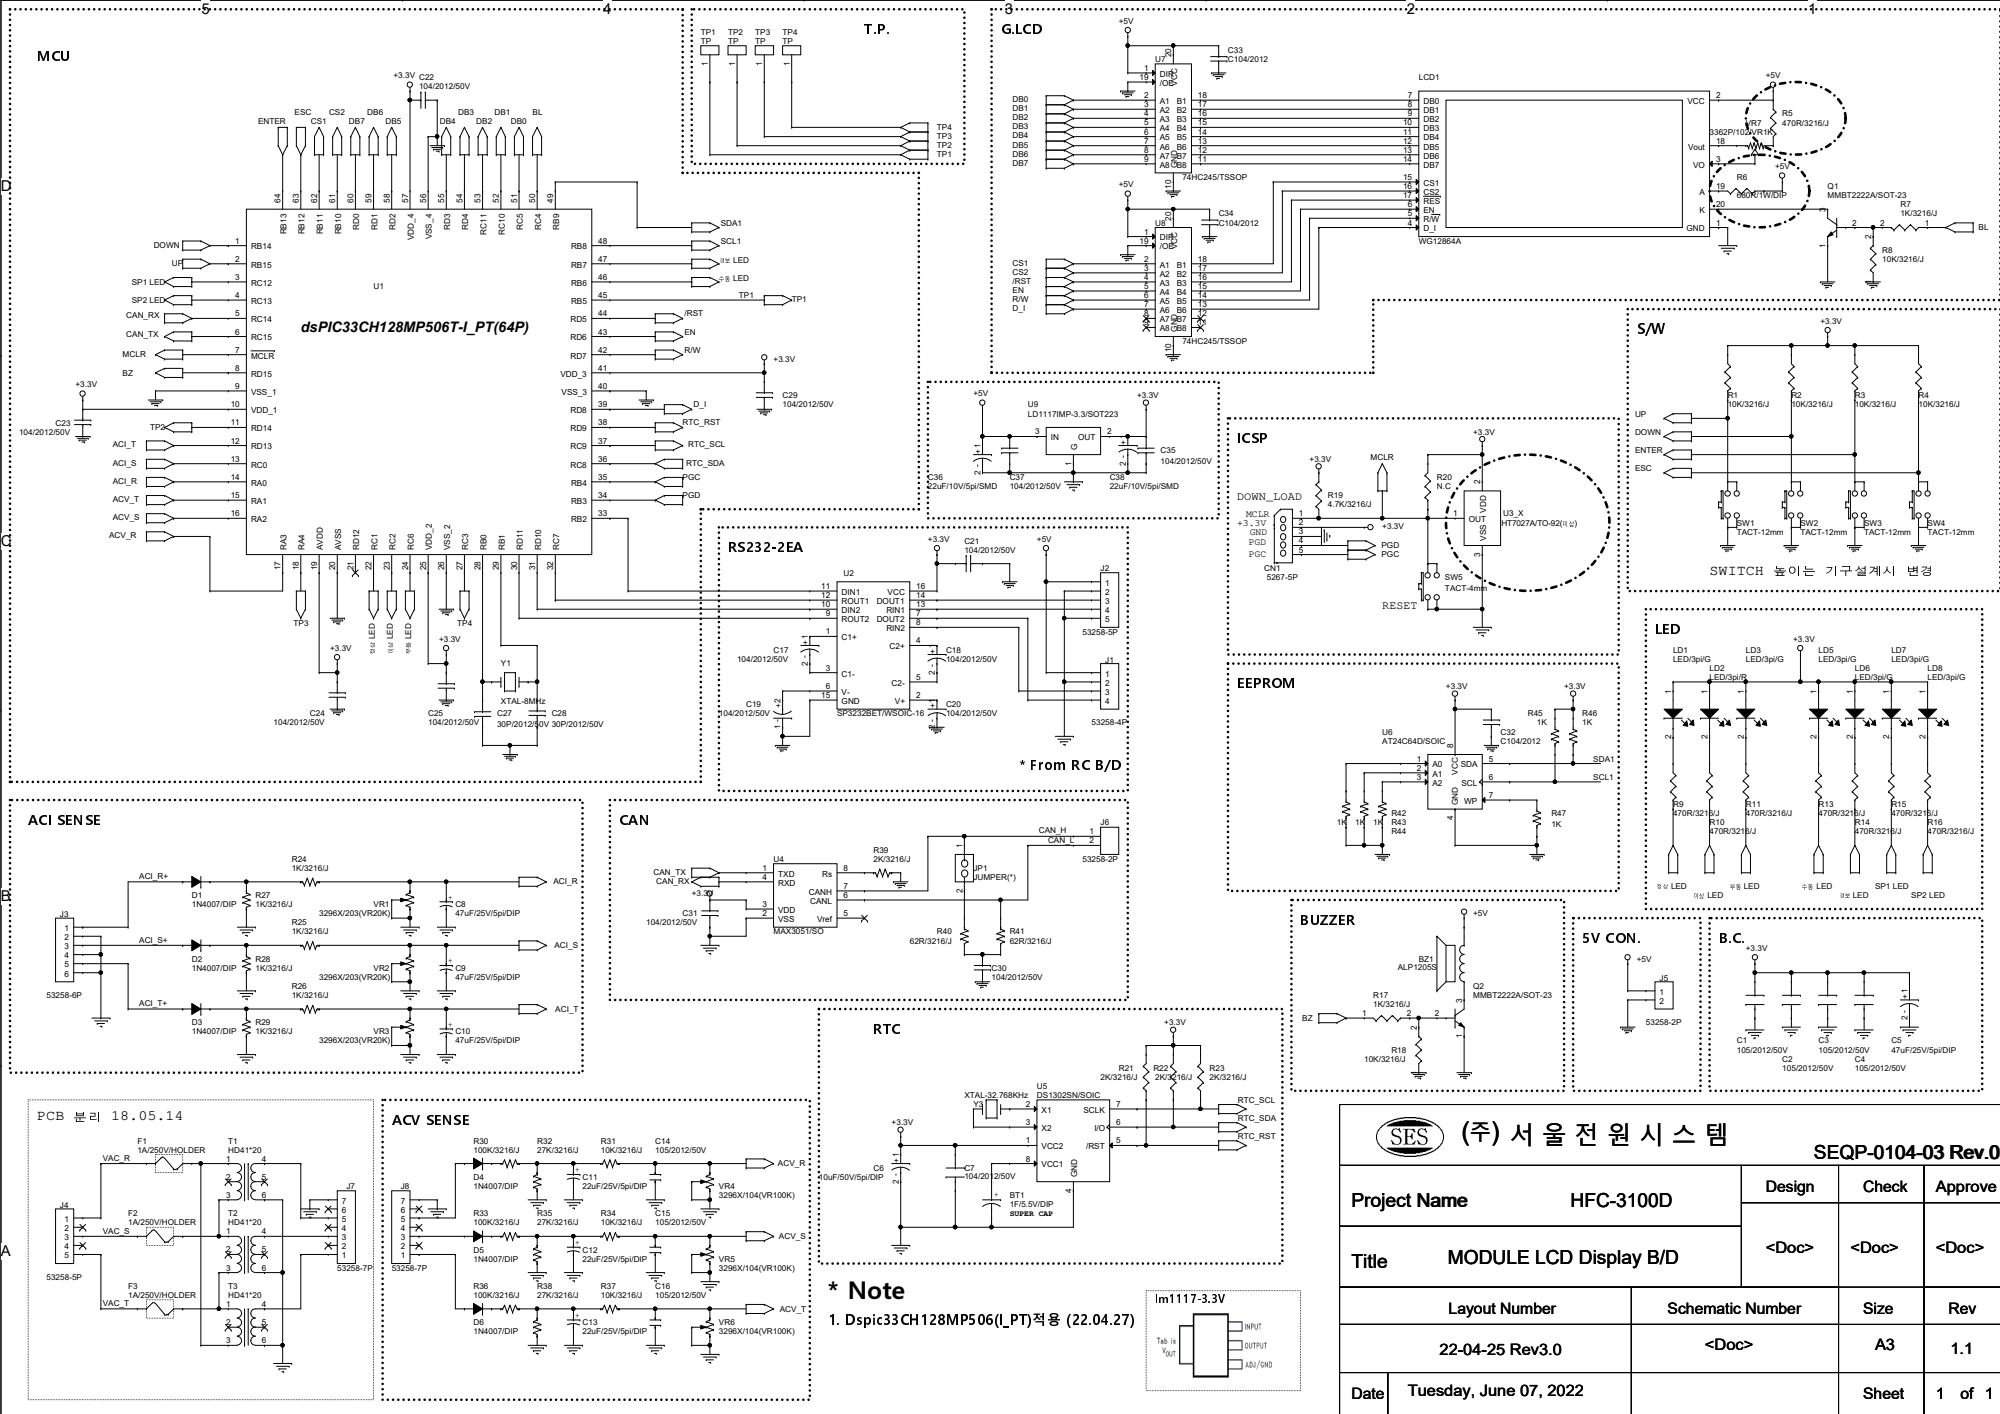
[picture p5: page 1]

SWITCH 높이는 기구설계시 변경
