gitDiceman/dspic33chSchematic/NEW_33CH128_SCHEMATIC/temp/MC_CPU(DSPIC33CH128MP508).pdf

SENSING1 | MCU | INPUT BUFFER

# C22 M222/2A D20

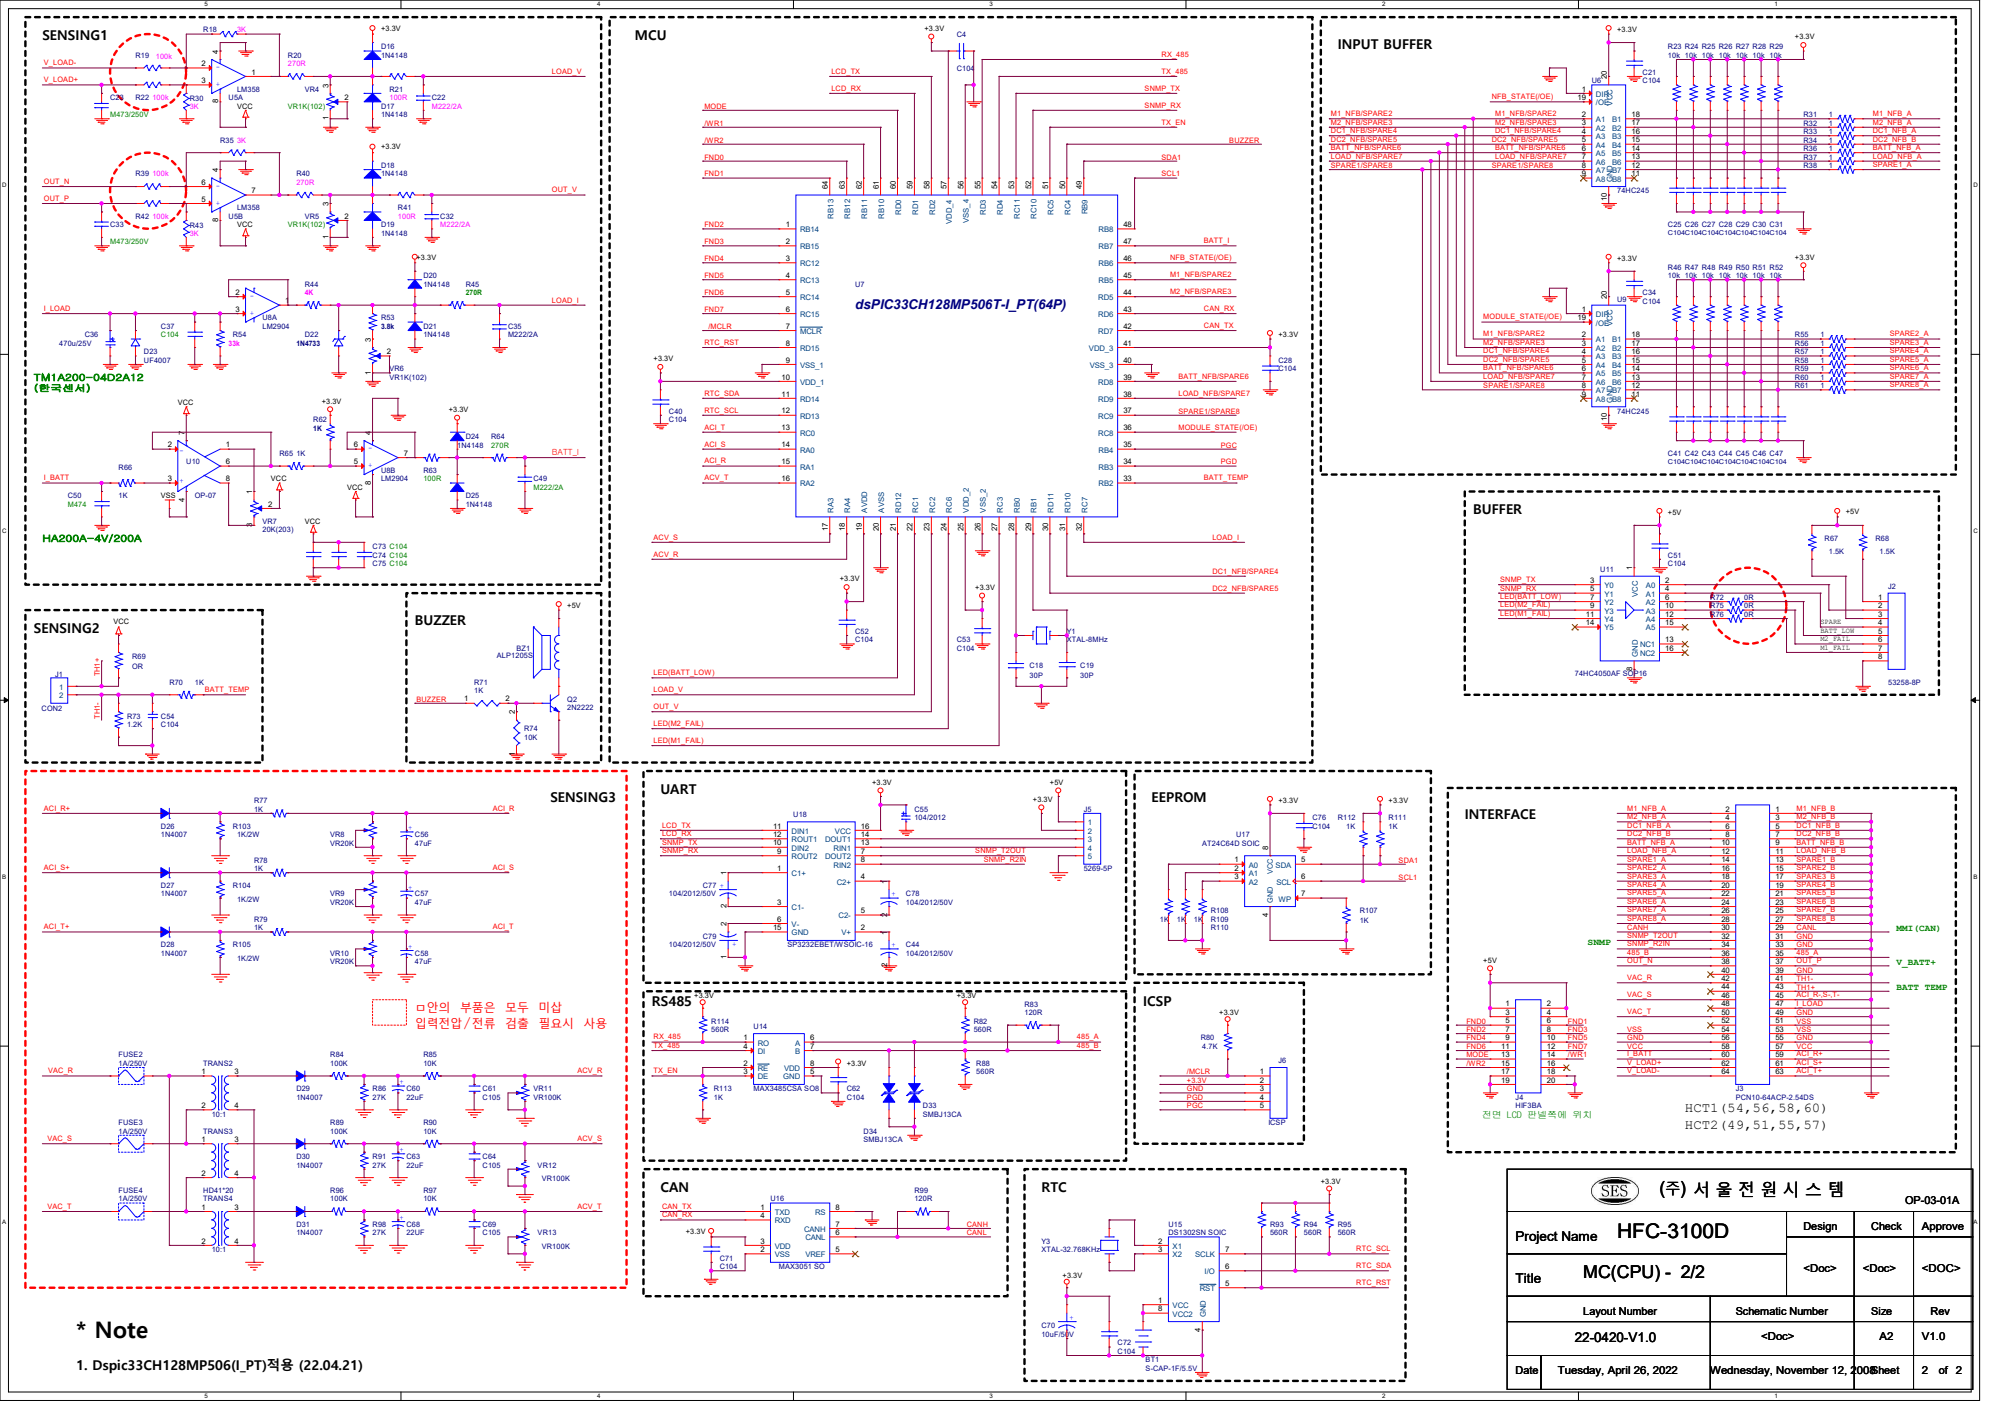
[picture p6: page 1]

ㅁ안의 부품은 모두 미삽
입력전압 전류 검출 필요시 사용 /

전면 LCD 판넬쪽에 위치
