gitDiceman/dspic33chSchematic/NEW_33CH128_SCHEMATIC/temp/MD(DSPIC33CH128MP508).pdf

## PGCICSP

# LCD 20 x 4

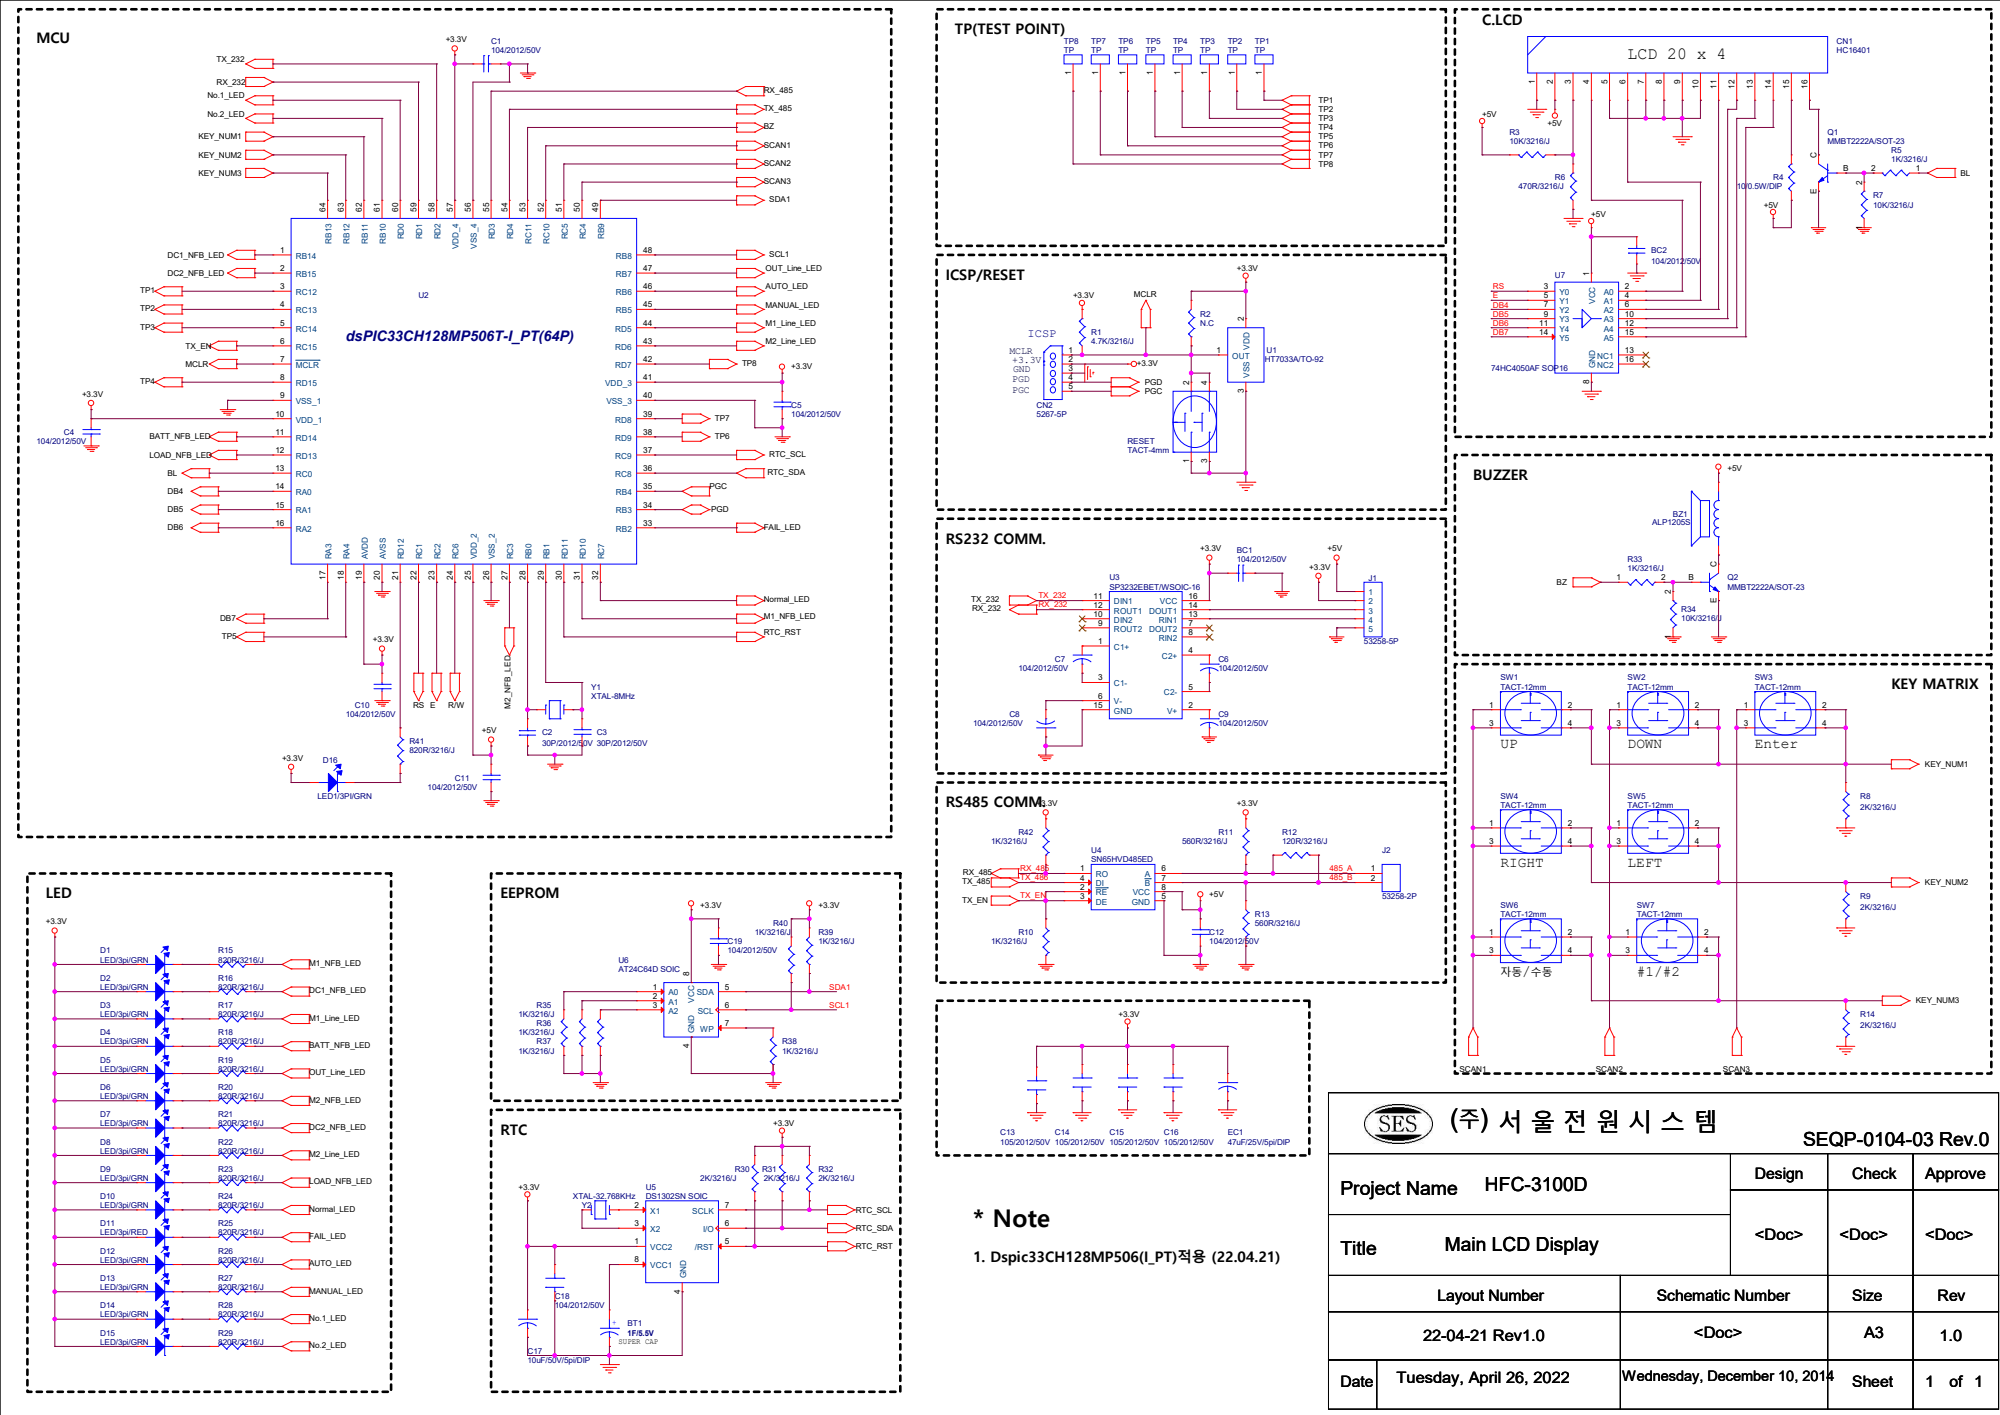
[picture p7: page 1]
