gitDiceman/dspic33chSchematic/gerbor/HFC3100D_Main LCD Display_220425_Rev2_0_GB/mainLcdgerbor.pdf

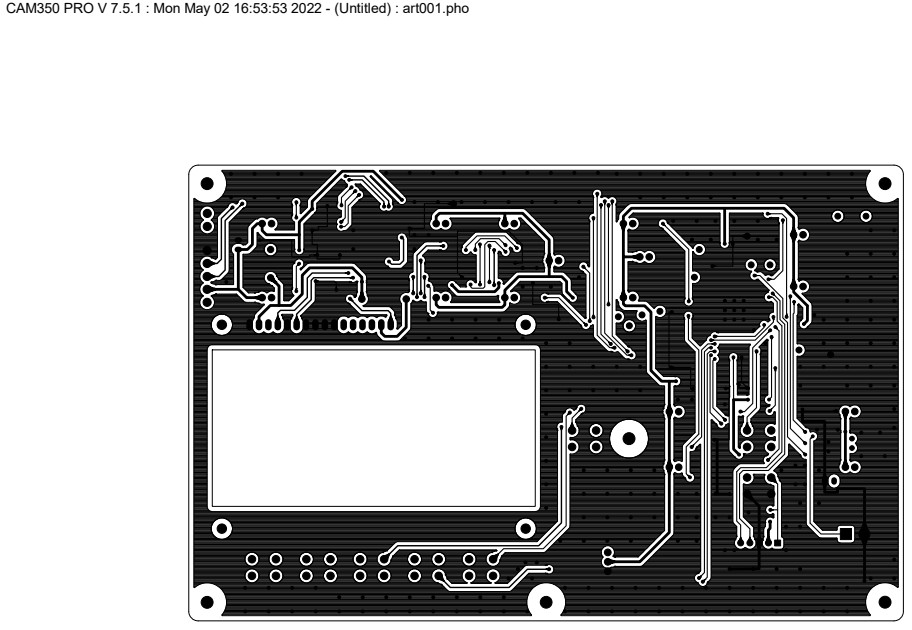
[picture p8: page 1]

CAM350 PRO V 7.5.1 : Mon May 02 16:53:53 2022 - (Untitled) : art001.pho

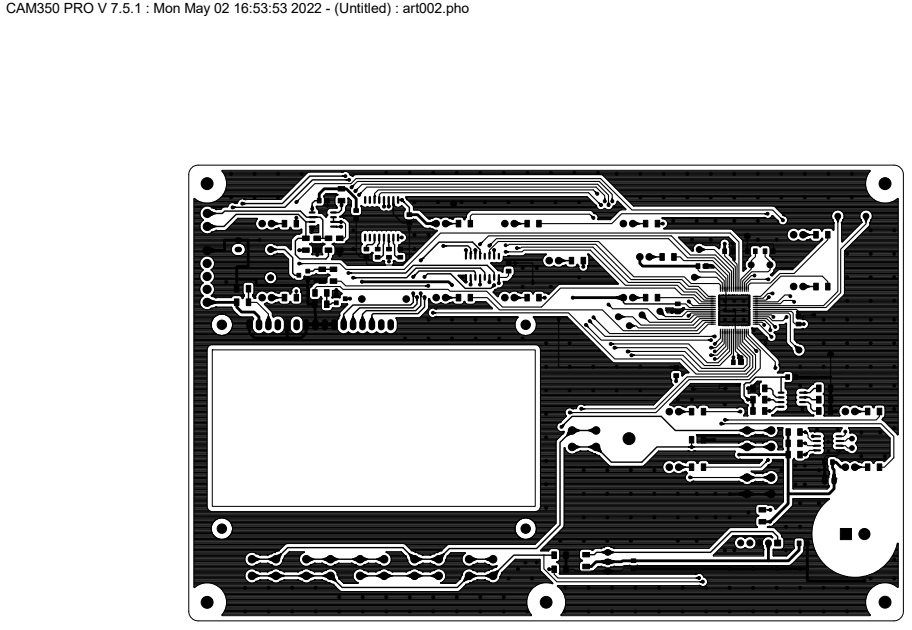
[picture p9: page 2]

CAM350 PRO V 7.5.1 : Mon May 02 16:53:53 2022 - (Untitled) : art002.pho

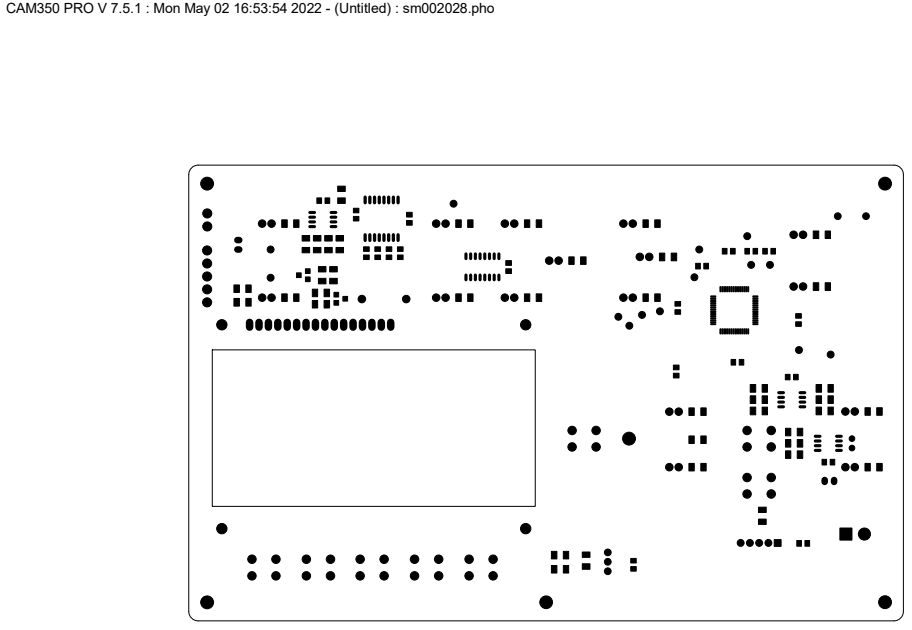
[picture p10: page 3]

CAM350 PRO V 7.5.1 : Mon May 02 16:53:54 2022 - (Untitled) : sm002028.pho

CAM350 PRO V 7.5.1 : Mon May 02 16:53:54 2022 - (Untitled) : smd002022.pho

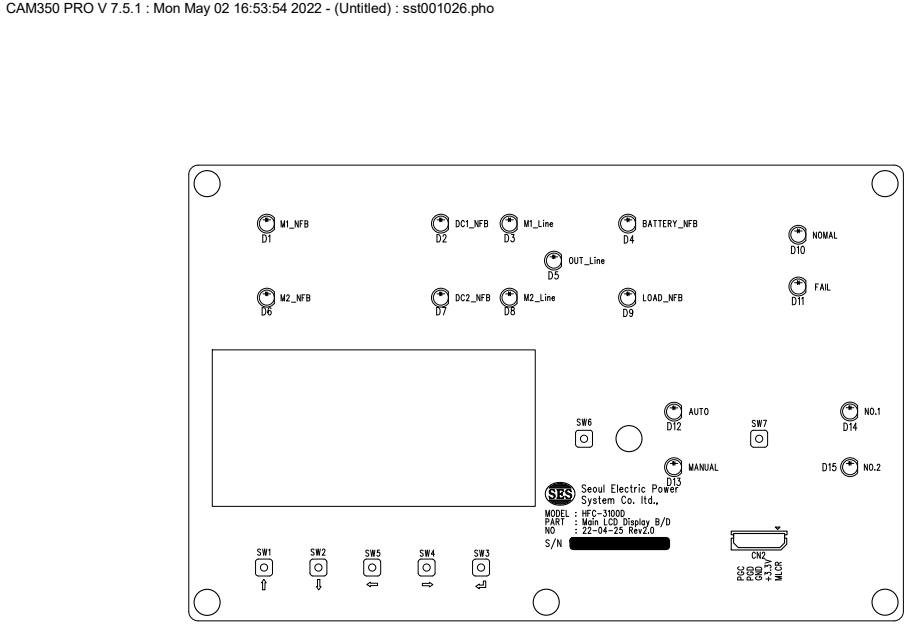
[picture p11: page 5]

CAM350 PRO V 7.5.1 : Mon May 02 16:53:54 2022 - (Untitled) : sst001026.pho
