gitDiceman/dspic33chSchematic/gerbor/HFC3100D_Module_Display_220425_Rev3_0_GB/RectifierDisplayGerbor.pdf

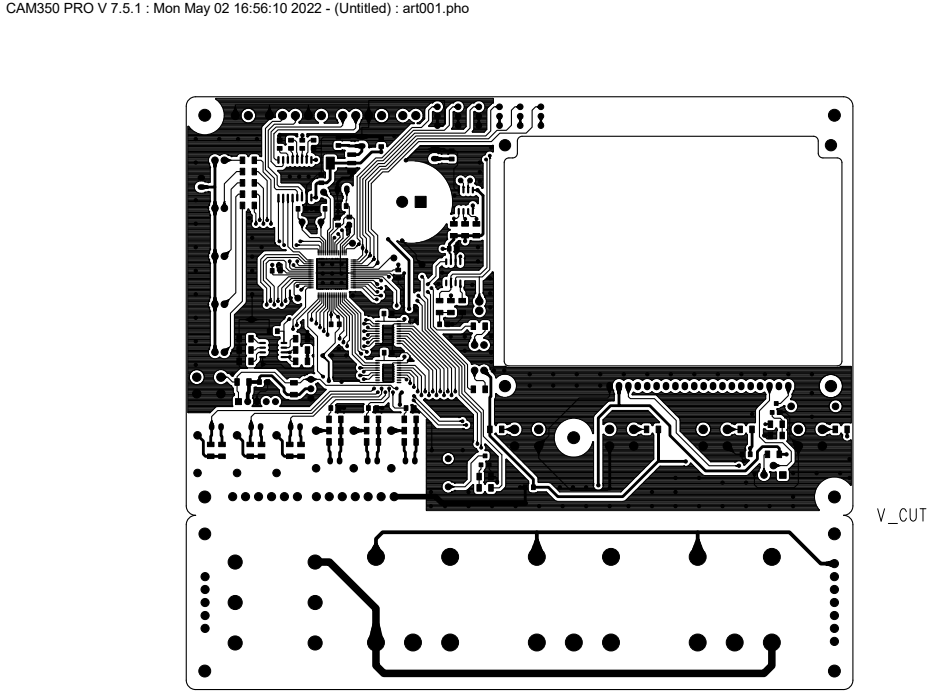
[picture p12: page 1]

CAM350 PRO V 7.5.1 : Mon May 02 16:56:10 2022 - (Untitled) : art001.pho

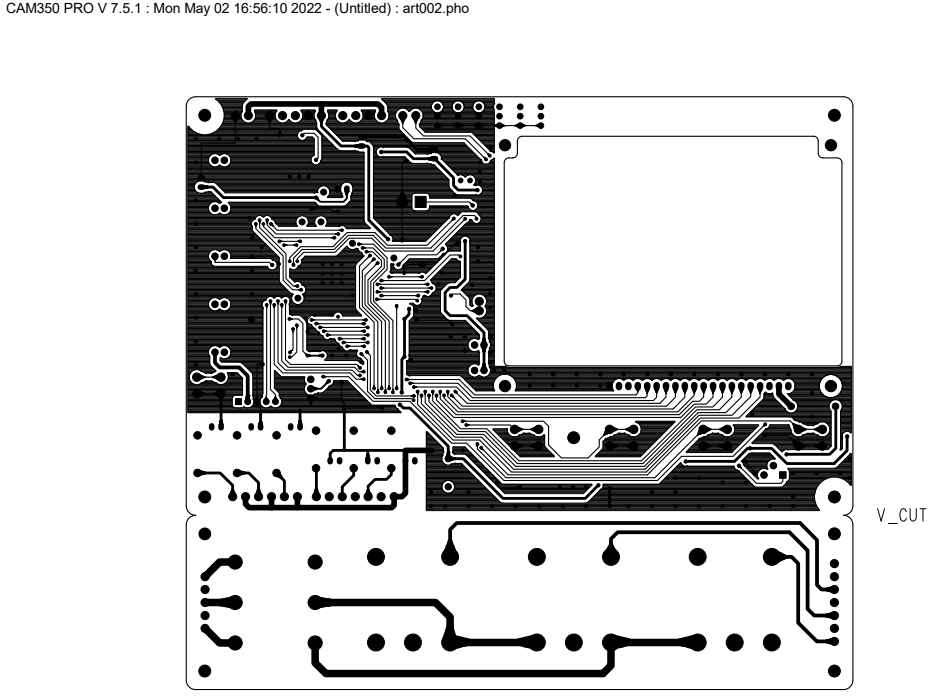
[picture p13: page 2]

CAM350 PRO V 7.5.1 : Mon May 02 16:56:10 2022 - (Untitled) : art002.pho

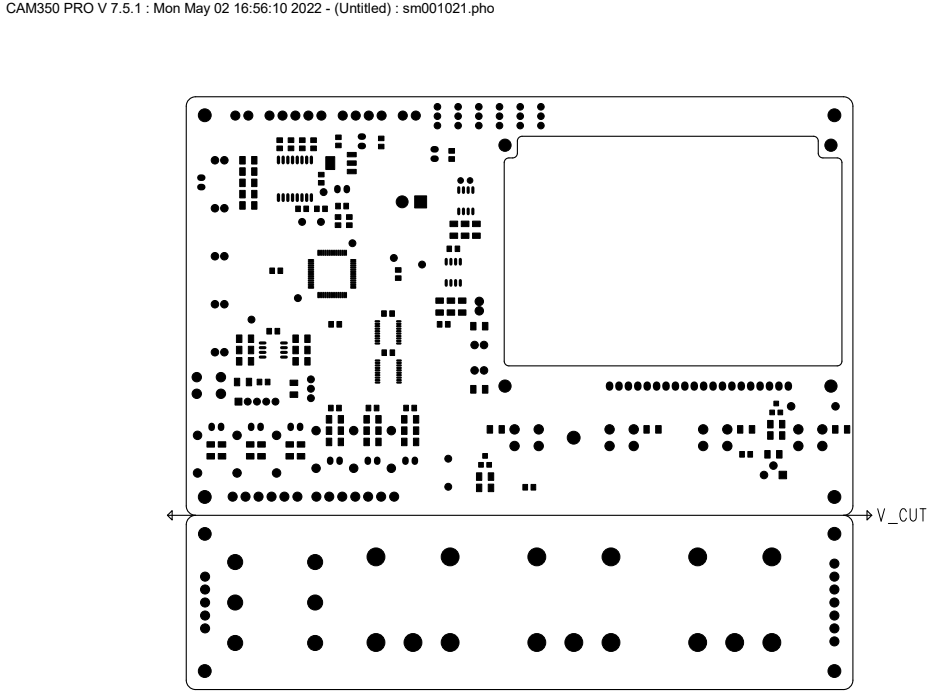
[picture p14: page 3]

CAM350 PRO V 7.5.1 : Mon May 02 16:56:10 2022 - (Untitled) : sm001021.pho

CAM350 PRO V 7.5.1 : Mon May 02 16:56:10 2022 - (Untitled) : smd001023.pho

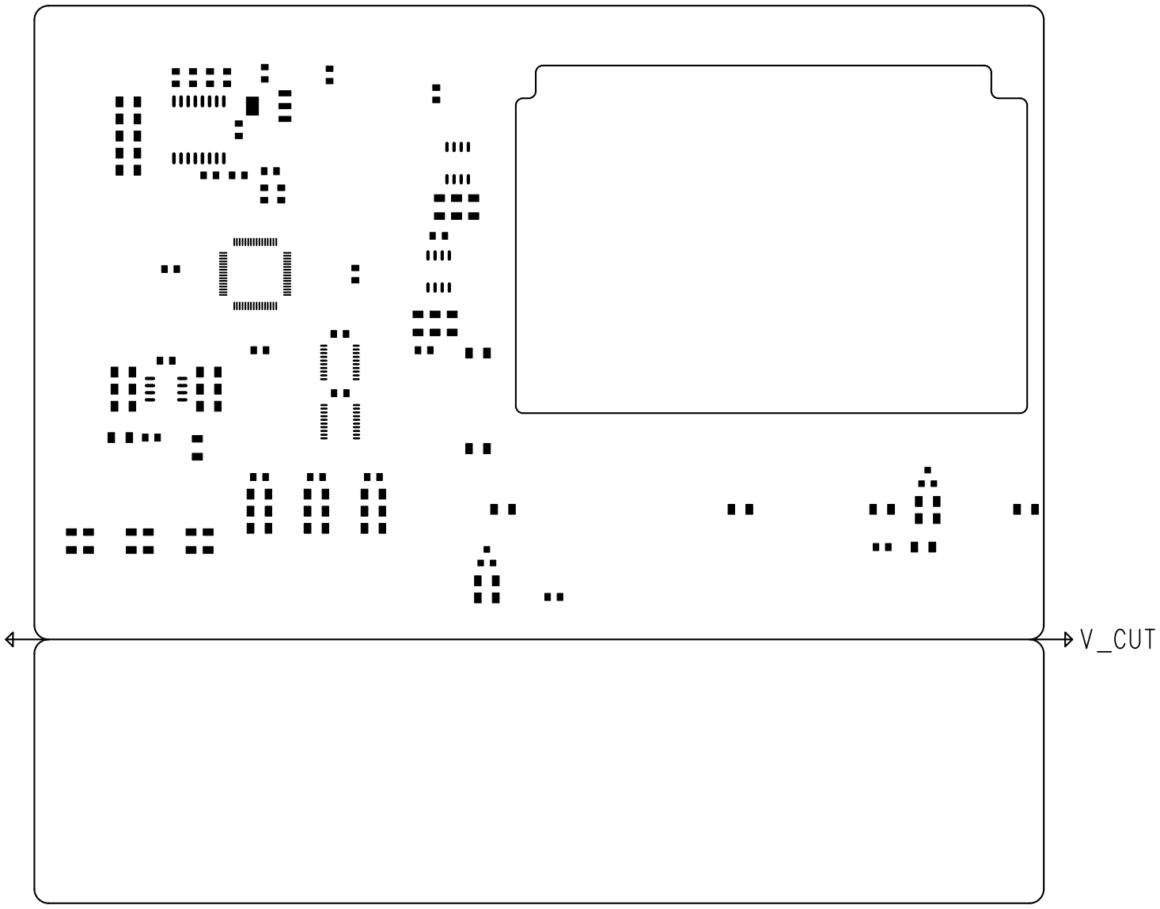
[picture p15: figure]
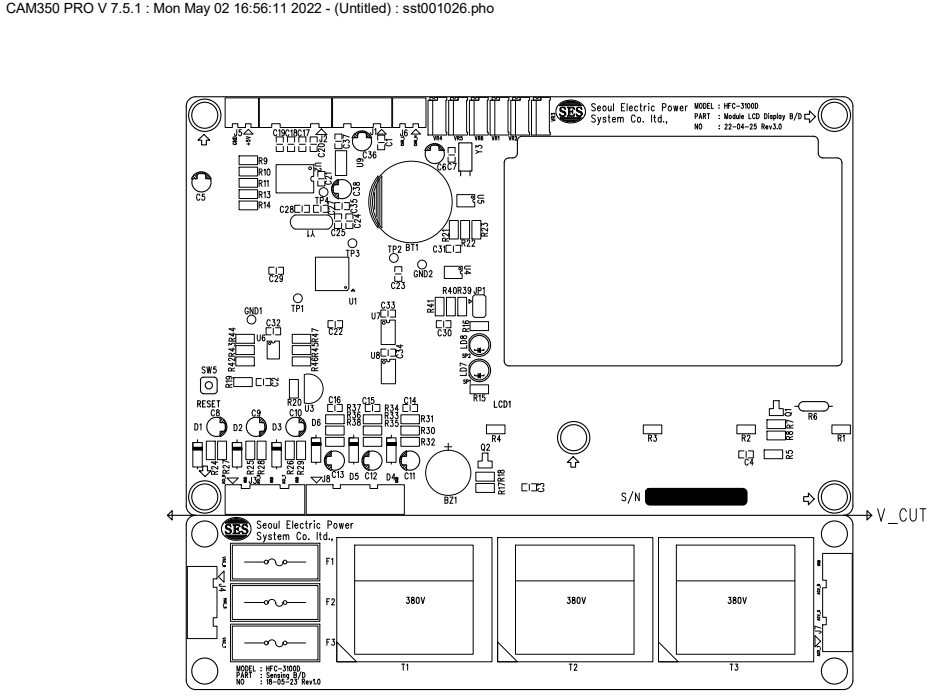
[picture p16: page 5]

CAM350 PRO V 7.5.1 : Mon May 02 16:56:11 2022 - (Untitled) : sst001026.pho
