gitDiceman/dspic33chSchematic/gerbor/HFC3100D_Main Control_220425_Rev2_0_GB/HFC3100D_Main Control_220425_Rev2_0_GB/mc_gerbor.pdf

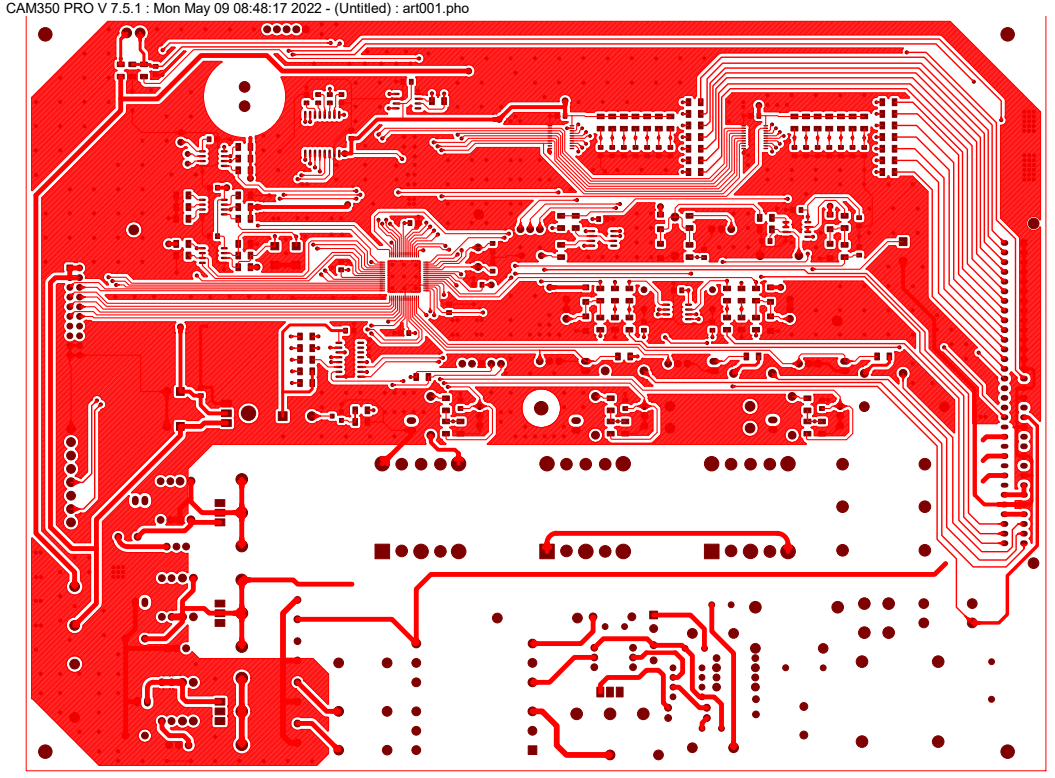
[picture p17: page 1]

CAM350 PRO V 7.5.1 : Mon May 09 08:48:17 2022 - (Untitled) : art001.pho

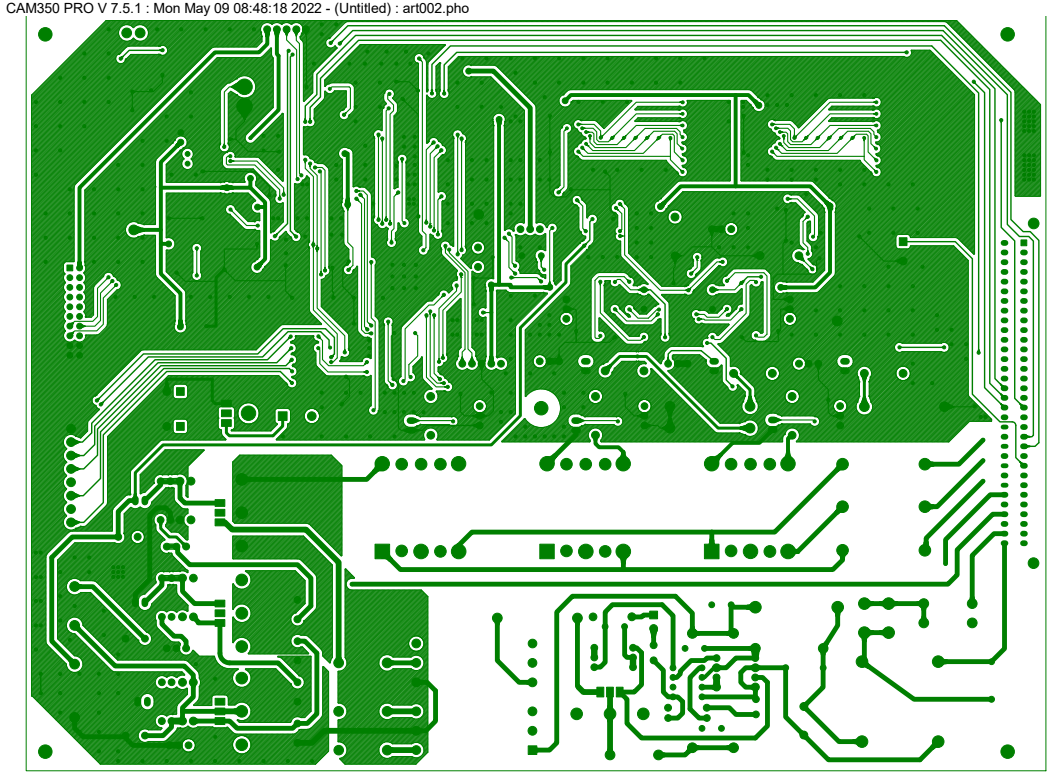
[picture p18: page 2]

CAM350 PRO V 7.5.1 : Mon May 09 08:48:18 2022 - (Untitled) : art002.pho

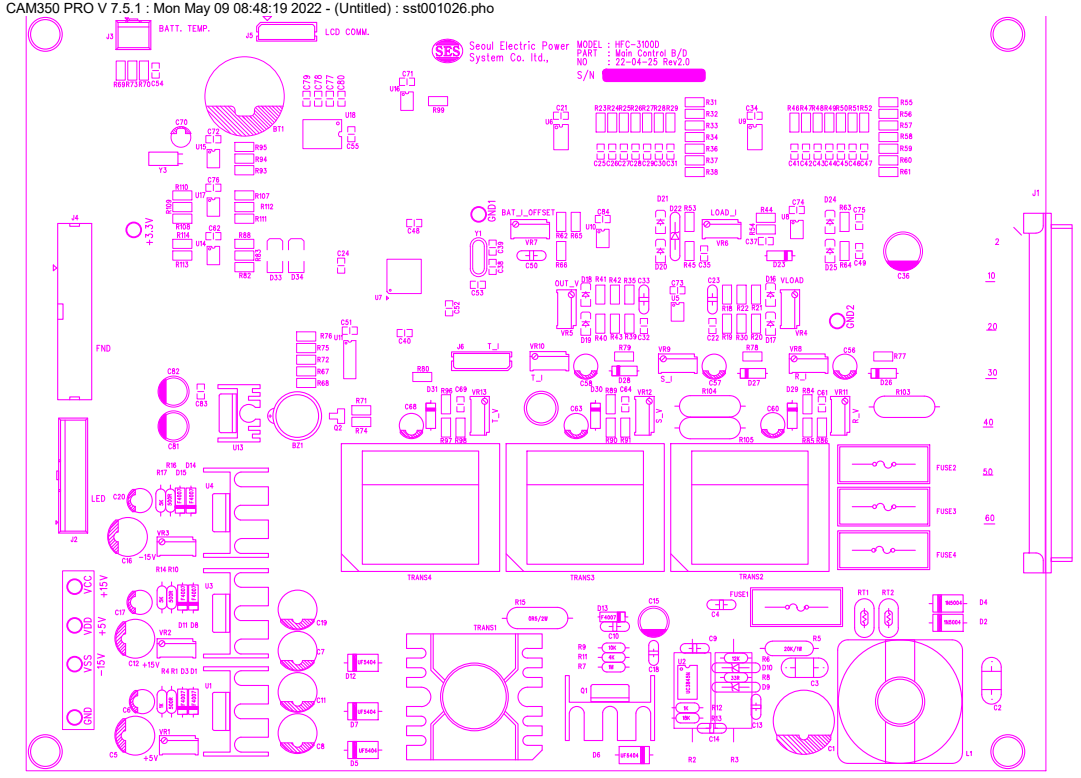
[picture p19: page 3]

CAM350 PRO V 7.5.1 : Mon May 09 08:48:19 2022 - (Untitled) : sst001026.pho
