gitDiceman/dspic33chSchematic/(list of files, drawings)

Other design files:
hfc3100D_main_Lcd_display_rev3/HFC3100D_Main LCD Display_220530_Rev3_0.pcb
HFC3100D_PCB(pads)/HFC3100D PCB(220928)/HFC3100D PCB/HFC3100D_Main Control_220928_Rev2_1.pcb
HFC3100D_PCB(pads)/HFC3100D PCB(220928)/HFC3100D PCB/HFC3100D_Module_Display_220928_Rev3_1.pcb
HFC3100D_PCB(pads)/HFC3100D_Main Control_220425_Rev2_0.pcb
HFC3100D_PCB(pads)/HFC3100D_Main LCD Display_220425_Rev2_0.pcb
HFC3100D_PCB(pads)/HFC3100D_Module_Display_220425_Rev3_0.pcb
MC(DSPIC32CH128MP506)_DC125V(220425_Rev2.0).DSN
MC(DSPIC32CH128MP506)_DC125V(220425_REV2.0).opj
MD(DSPIC33CH128MP506)_DC125V(220502).DSN
MD(DSPIC33CH128MP506)_DC125V(220502).opj
NEW_33CH128_SCHEMATIC/HFC3000_MC(DSPIC32CH128MP506)_DC48V(220627_REV2.0).opj
NEW_33CH128_SCHEMATIC/HFC3000_MC(DSPIC32CH128MP506)_DC48V(220925_Rev2.1).DSN
NEW_33CH128_SCHEMATIC/HFC3000_MC(DSPIC32CH128MP506)_DC48V(220925_REV2.1).opj
NEW_33CH128_SCHEMATIC/mc(dspic32ch128mp506)_dc125v(220425_rev2.0).opj
NEW_33CH128_SCHEMATIC/MC(DSPIC32CH128MP506)_DC125V(220925_Rev2.1).DSN
NEW_33CH128_SCHEMATIC/MC(DSPIC32CH128MP506)_DC125V(220925_REV2.1).opj
NEW_33CH128_SCHEMATIC/md(dspic33ch128mp506)_dc125v(220502).opj
NEW_33CH128_SCHEMATIC/MD(DSPIC33CH128MP506)_DC125V(220502_REv2.0).DSN
NEW_33CH128_SCHEMATIC/MD(DSPIC33CH128MP506)_DC125V(220502_REV2.0).opj
NEW_33CH128_SCHEMATIC/pcb/HFC-3100D_Display_V_1_0_20161209.pcb
NEW_33CH128_SCHEMATIC/rd(dspic33ch128mp506)_dc125v(220502).opj
NEW_33CH128_SCHEMATIC/RD(DSPIC33CH128MP506)_DC125V_Rev3.1(220925).DSN
NEW_33CH128_SCHEMATIC/RD(DSPIC33CH128MP506)_DC125V_REV3.1(220925).opj
RD(DSPIC33CH128MP506)_DC125V_Rev3.0(220502).DSN
RD(DSPIC33CH128MP506)_DC125V_REV3.0(220502).opj
